mgpauly1458/ttihp26b-project/docs/dac_rows_layout.png

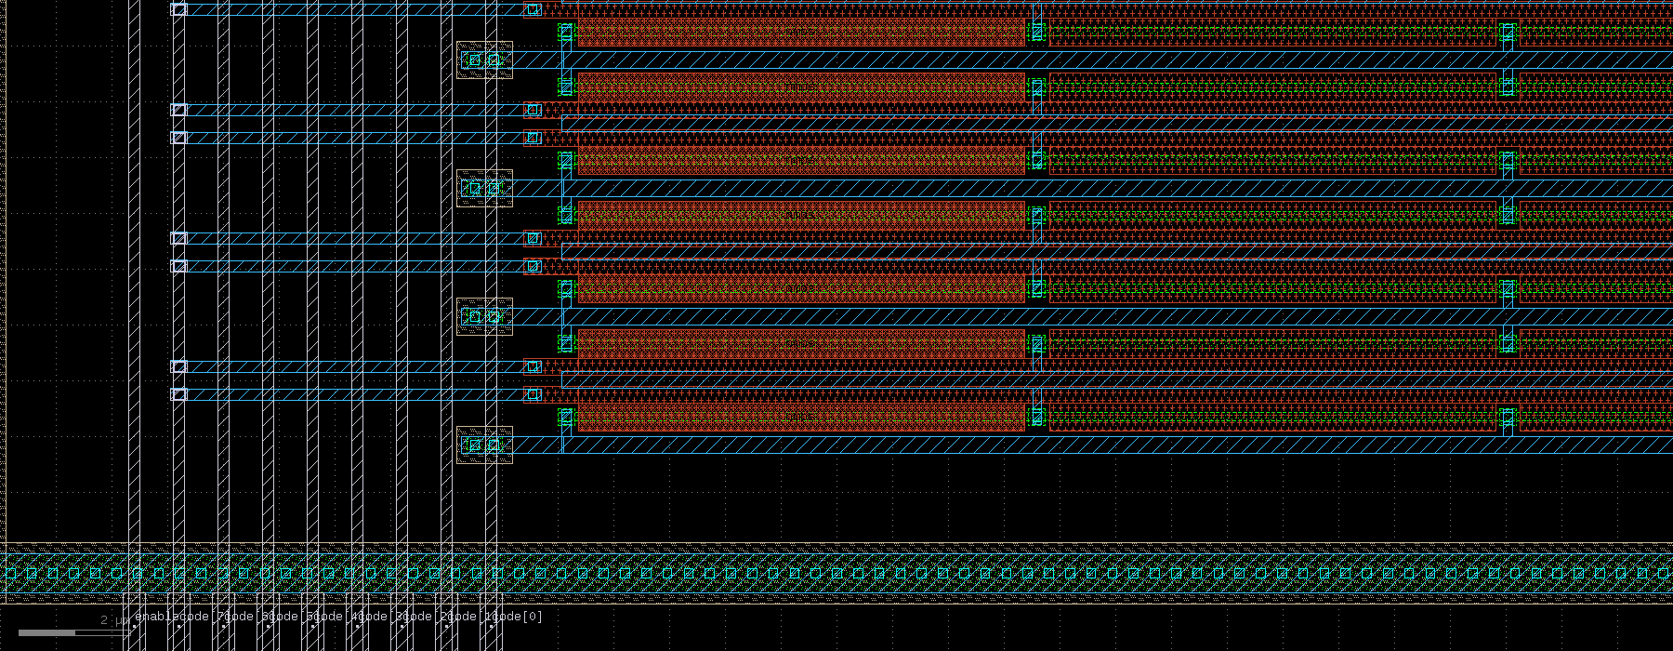
docs/dac_rows_layout.png
