mgpauly1458/ttihp26b-project/docs/ring_row_layout.png

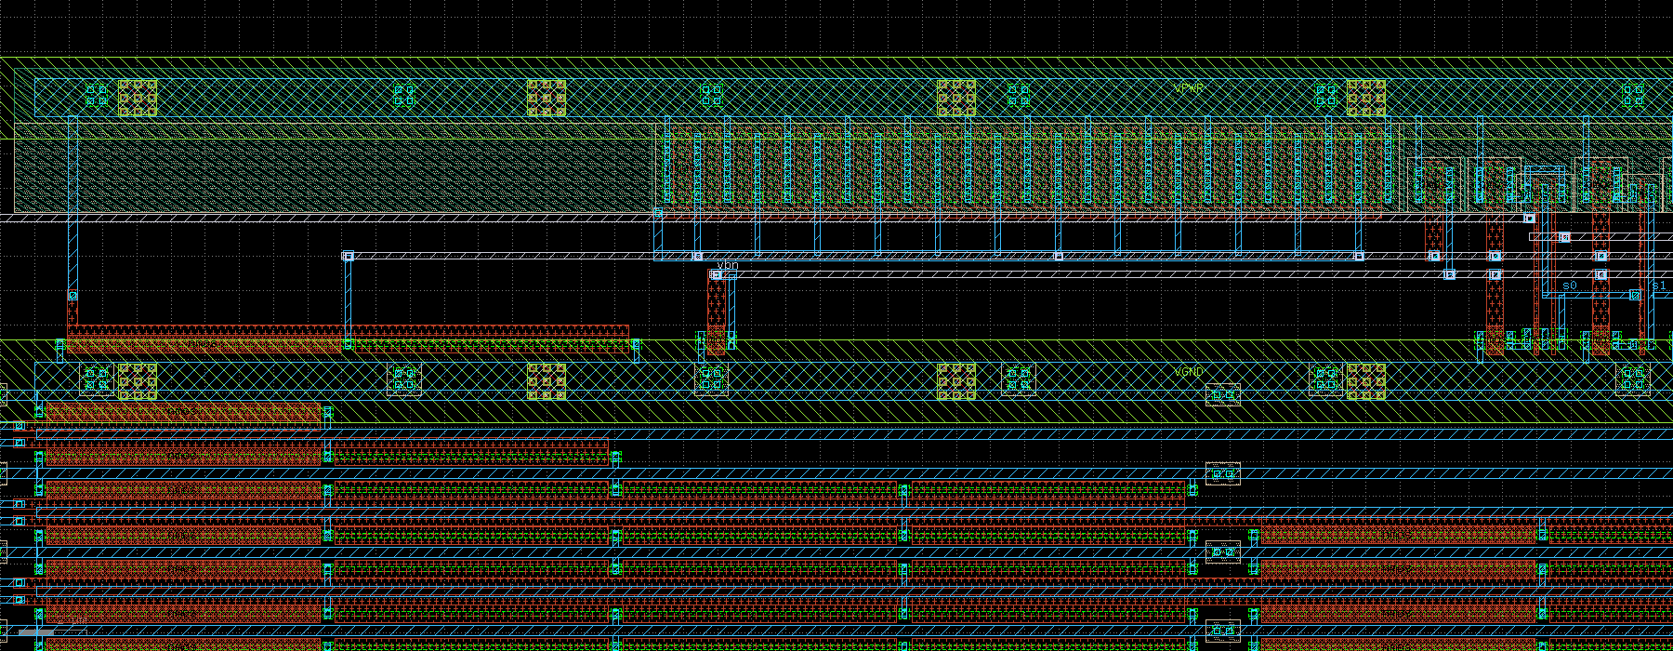
docs/ring_row_layout.png
