mgpauly1458/ttihp26b-project/docs/sch_csro_dac.png

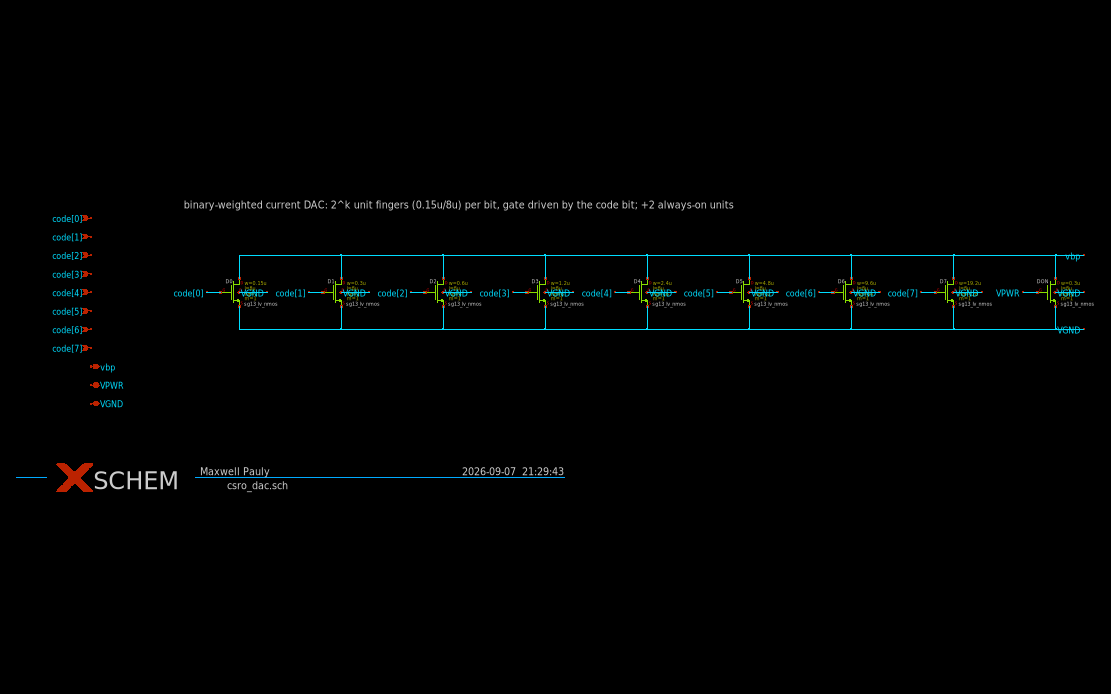
docs/sch_csro_dac.png
