mgpauly1458/ttihp26b-project/docs/sch_csro_inv.png

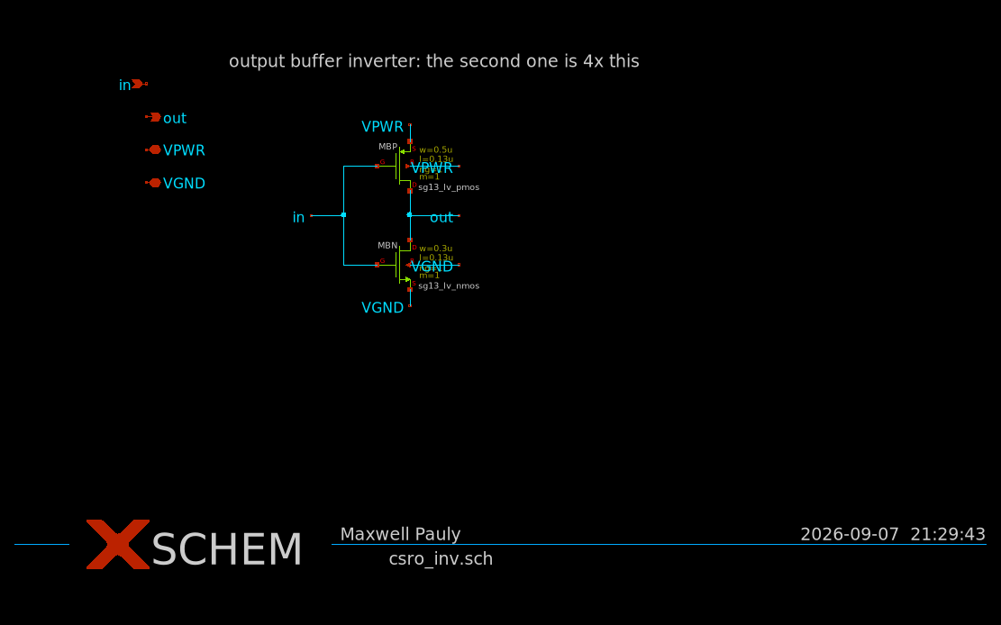
docs/sch_csro_inv.png
