mgpauly1458/ttihp26b-project/docs/sweep_error.png

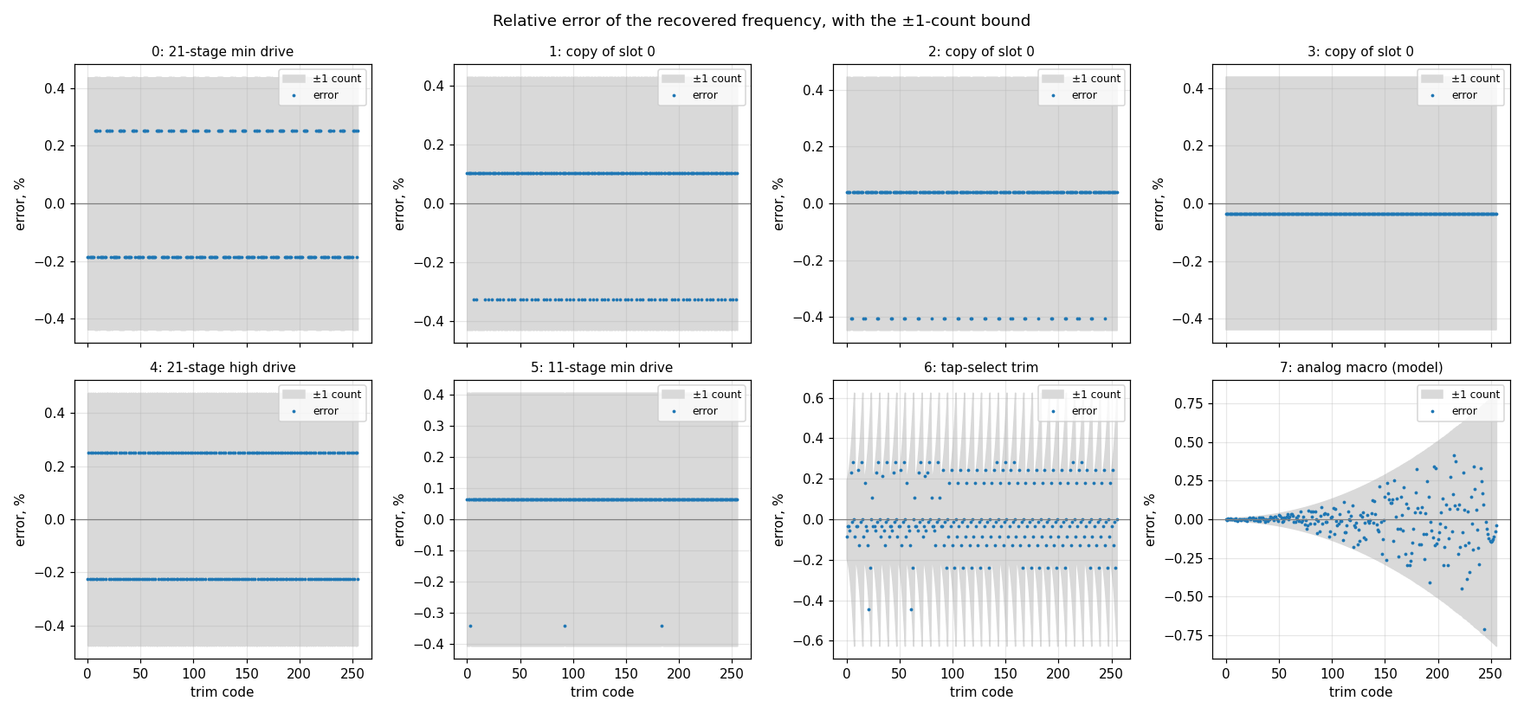
docs/sweep_error.png
