mgpauly1458/ttihp26b-project/docs/analog_verification_results.md

# Analog block verification: results

GENERATED by `make -C analog verify sim-post verify-ring-post verify-env verify-env-post` (analog/verify/*.py, ngspice in the iic-osic-tools container) on 2026-09-07. The strategy, and what the numbers mean, is in [analog_verification.md](analog_verification.md). Do not edit; rerun.

Corner names: process (tt, ss, ff, sf, fs) _ temperature _ supply. `SIGNOFF` corners are the three the tile's STA uses: tt 27 C 1.20 V, ss 125 C 1.08 V, ff -40 C 1.32 V.

---

## DAC: current against code
Drain held at 0.6 V. Endpoint fit; DNL/INL in units of the fitted LSB.
**Signoff corners** (the three LibreLane times the tile at):
| PVT | I(0) uA | I(1)-I(0) uA | unit uA | I(255) uA | DNL min | DNL max | at code | |INL| max | monotonic |
|---|---|---|---|---|---|---|---|---|---|
| tt_27C_1.20V | 5.16 | 2.58 | 2.575 | 662 | -0.000 | 0.000 | 128 | 0.00 | yes |
| ss_125C_1.08V | 2.66 | 1.31 | 1.307 | 336 | -0.000 | 0.000 | 128 | 0.00 | yes |
| ff_-40C_1.32V | 8.62 | 4.31 | 4.306 | 1107 | -0.000 | 0.000 | 128 | 0.00 | yes |

**All 45 PVT points**, extremes:
|  | min | at | max | at |
|---|---|---|---|---|
| unit current uA | 1.307 | ss_125C_1.08V | 4.306 | ff_-40C_1.32V |
| full scale uA | 336 | ss_125C_1.08V | 1107 | ff_-40C_1.32V |
| code-0 current uA | 2.66 | ss_125C_1.08V | 8.62 | ff_-40C_1.32V |
| DNL min | -0.001 | ff_125C_1.32V | -0.000 | ss_-40C_1.08V |
| DNL max | 0.000 | ss_-40C_1.08V | 0.000 | ff_125C_1.32V |
| |INL| max | 0.00 | ss_-40C_1.08V | 0.00 | ff_125C_1.32V |

Monotonic at 45 of 45 PVT points.

**Drain voltage sensitivity** (typical): the units are in triode, so the current follows the drain.
| PVT | I(0) uA | I(1)-I(0) uA | unit uA | I(255) uA | DNL min | DNL max | at code | |INL| max | monotonic |
|---|---|---|---|---|---|---|---|---|---|
| tt_27C_1.20V | 5.16 | 2.58 | 2.575 | 662 | -0.000 | 0.000 | 128 | 0.00 | yes |
| tt_27C_1.20V_vd0.46 | 4.43 | 2.21 | 2.212 | 569 | -0.000 | 0.000 | 128 | 0.00 | yes |
| tt_27C_1.20V_vd0.85 | 5.66 | 2.82 | 2.825 | 726 | -0.000 | 0.000 | 128 | 0.00 | yes |

## DAC: mismatch Monte Carlo, 200 samples (mos_tt_mismatch, 27 C, 1.2 V)
|  | value |
|---|---|
| samples monotonic | 200 / 200 |
| worst DNL (most negative step) | -0.393 LSB at code 128 |
| DNL min, mean over samples | -0.106 LSB |
| |INL| max, worst sample | 0.25 LSB |
| worst-DNL codes (count) | 128 (70), 64 (30), 192 (19) |
| unit current sigma/mean | 0.05 % |

## DAC: process Monte Carlo, 100 samples (mos_tt_stat, 27 C, 1.2 V)
|  | mean | sigma | sigma/mean | min | max |
|---|---|---|---|---|---|
| unit current uA | 2.560 | 0.113 | 4.4 % | 2.304 | 2.793 |
| code-0 current uA | 5.13 | 0.24 | 4.6 % | 4.61 | 5.67 |

Monotonic in 100 / 100 samples (global variation moves every finger together, so it cannot break the weighting).

---

## Bias chain: operating points against code
Stage starve devices measured with their drains at 0.6 V. The nominal mirror ratio is 48:1 (24 x 2 um diode, 1 um stage device).

**Signoff corners:**
| PVT | code | vbp V | vbn V | I_dac uA | I_stage(p) uA | I_stage(n) uA | I_dac/I_stage |
|---|---|---|---|---|---|---|---|
| tt_27C_1.20V | 0 | 0.855 | 0.255 | 5.7 | 0.13 | 0.18 | 44.0 |
| tt_27C_1.20V | 1 | 0.839 | 0.270 | 8.5 | 0.19 | 0.27 | 44.1 |
| tt_27C_1.20V | 16 | 0.746 | 0.352 | 49.9 | 1.12 | 1.33 | 44.7 |
| tt_27C_1.20V | 128 | 0.557 | 0.501 | 322.6 | 7.04 | 7.34 | 45.8 |
| tt_27C_1.20V | 255 | 0.461 | 0.572 | 569.3 | 12.32 | 12.45 | 46.2 |
| ss_125C_1.08V | 0 | 0.804 | 0.196 | 2.8 | 0.06 | 0.09 | 45.7 |
| ss_125C_1.08V | 1 | 0.785 | 0.213 | 4.2 | 0.09 | 0.14 | 45.7 |
| ss_125C_1.08V | 16 | 0.687 | 0.303 | 24.5 | 0.53 | 0.68 | 45.9 |
| ss_125C_1.08V | 128 | 0.514 | 0.453 | 158.6 | 3.41 | 3.66 | 46.6 |
| ss_125C_1.08V | 255 | 0.430 | 0.523 | 282.8 | 6.03 | 6.24 | 46.9 |
| ff_-40C_1.32V | 0 | 0.962 | 0.271 | 10.0 | 0.24 | 0.34 | 40.8 |
| ff_-40C_1.32V | 1 | 0.947 | 0.284 | 14.9 | 0.36 | 0.49 | 41.1 |
| ff_-40C_1.32V | 16 | 0.852 | 0.364 | 88.3 | 2.05 | 2.39 | 43.0 |
| ff_-40C_1.32V | 128 | 0.639 | 0.522 | 578.7 | 12.87 | 13.25 | 45.0 |
| ff_-40C_1.32V | 255 | 0.525 | 0.600 | 1021.1 | 22.46 | 22.46 | 45.5 |

**All 45 PVT points**, per-stage PMOS current extremes (this is what sets the ring's delay):
| code | min I_stage(p) uA | at | max I_stage(p) uA | at | max/min |
|---|---|---|---|---|---|
| 0 | 0.06 | ss_125C_1.08V | 0.24 | ff_-40C_1.32V | 4.0 |
| 1 | 0.09 | ss_125C_1.08V | 0.36 | ff_-40C_1.32V | 3.9 |
| 16 | 0.53 | ss_125C_1.08V | 2.05 | ff_-40C_1.32V | 3.8 |
| 128 | 3.41 | ss_125C_1.08V | 12.87 | ff_-40C_1.32V | 3.8 |
| 255 | 6.03 | ss_125C_1.08V | 22.46 | ff_-40C_1.32V | 3.7 |

I_dac / I_stage(p) over every PVT point and code >= 1: 41.1 .. 47.3 (nominal 48; the deviation is the diode and the stage device sitting at different drain voltages).

## Bias chain: mismatch Monte Carlo, 200 samples (mos_tt_mismatch, 27 C, 1.2 V)
| code | stage PMOS current sigma/mean %, mean | worst sample | worst max-min % | stage NMOS sigma/mean % | MPM/MPD ratio sigma % | I_dac sigma % |
|---|---|---|---|---|---|---|
| 1 | 7.4 | 12.4 | 42.5 | 18.9 | 8.1 | 1.32 |
| 16 | 4.5 | 7.8 | 26.8 | 12.4 | 4.9 | 0.26 |
| 255 | 1.7 | 3.1 | 10.8 | 5.3 | 1.9 | 0.11 |

Each row: across the eleven stages within one sample (mean and worst over samples), then the mirror ratio and the DAC current across samples.

## Bias chain: noise at the bias nodes (typical, 27 C, 1.2 V)
| code | vbn noise uVrms 1k-1G | 1-1G | 1k-1M | vbn LSB step mV | noise/LSB % (1k-1G) | noise/LSB % (1k-1M) | vbp noise uVrms 1k-1G | 1-1G | 1k-1M | vbp LSB step mV | noise/LSB % (1k-1G) | noise/LSB % (1k-1M) |
|---|---|---|---|---|---|---|---|---|---|---|---|---|
| 1 | 679.1 | 686.3 | 124.4 | 11.17 | 6.1 | 1.11 | 189.0 | 189.4 | 15.9 | 12.24 | 1.5 | 0.13 |
| 16 | 585.3 | 594.1 | 109.3 | 3.12 | 18.8 | 3.50 | 147.4 | 147.9 | 13.8 | 3.72 | 4.0 | 0.37 |
| 128 | 499.1 | 511.5 | 114.2 | 0.75 | 66.9 | 15.29 | 86.2 | 87.3 | 14.0 | 0.99 | 8.7 | 1.41 |
| 255 | 473.5 | 488.1 | 120.0 | 0.43 | 110.3 | 27.95 | 66.2 | 67.6 | 14.0 | 0.59 | 11.2 | 2.36 |

Integrated output noise (rms) of the bias nodes with the code held, from ngspice `.noise` (PSP thermal + flicker; ngspice reports onoise_total as the rms voltage). "LSB step" is how far the node moves for one code step at that code; noise/LSB is the rms noise as a percentage of that step. The 1 kHz-1 GHz figure is everything the node carries; most of it is white noise above 1 MHz, which the ring turns into period jitter that a reciprocal count averages (ring.py measures that directly). The 1 kHz-1 MHz figure is the slow part that behaves like a code error within one measurement, and is the one to compare with a code step.

---

## Stage: delay against code and corner
A starved inverter driven by and loading identical stages, with the real bias chain at the code shown. The last column is 1 / (11 x (tPLH + tPHL)): the period an 11-stage ring of these would have.

**Signoff corners:**
| PVT | code | tPLH ps | tPHL ps | mean ps | rise 20-80 ps | fall 20-80 ps | slope up V/ns | slope down V/ns | 11-stage ring MHz |
|---|---|---|---|---|---|---|---|---|---|
| tt_27C_1.20V | 0 | 9818 | 10878 | 10348 | 16233 | 11466 | 0.05 | 0.10 | 4.4 |
| tt_27C_1.20V | 16 | 1011 | 1208 | 1110 | 1801 | 1443 | 0.53 | 0.67 | 41.0 |
| tt_27C_1.20V | 128 | 170 | 210 | 190 | 262 | 238 | 3.46 | 3.39 | 238.8 |
| tt_27C_1.20V | 255 | 114 | 136 | 125 | 154 | 139 | 6.07 | 5.72 | 363.4 |
| ss_125C_1.08V | 0 | 17341 | 20090 | 18716 | 29550 | 21057 | 0.02 | 0.05 | 2.4 |
| ss_125C_1.08V | 16 | 1765 | 2253 | 2009 | 3198 | 2649 | 0.28 | 0.32 | 22.6 |
| ss_125C_1.08V | 128 | 309 | 390 | 350 | 457 | 431 | 1.81 | 1.71 | 130.0 |
| ss_125C_1.08V | 255 | 203 | 250 | 227 | 261 | 252 | 3.17 | 2.89 | 200.5 |
| ff_-40C_1.32V | 0 | 6586 | 6502 | 6544 | 10035 | 6666 | 0.08 | 0.18 | 6.9 |
| ff_-40C_1.32V | 16 | 673 | 751 | 712 | 1152 | 873 | 0.79 | 1.27 | 63.9 |
| ff_-40C_1.32V | 128 | 104 | 128 | 116 | 171 | 148 | 5.76 | 6.00 | 391.6 |
| ff_-40C_1.32V | 255 | 69 | 83 | 76 | 102 | 87 | 10.25 | 10.04 | 598.0 |

**All 45 PVT points**, delay extremes:
| code | fastest mean delay ps | at | slowest mean delay ps | at | slow/fast |
|---|---|---|---|---|---|
| 0 | 6544 | ff_-40C_1.32V | 19033 | sf_125C_1.08V | 2.91 |
| 16 | 712 | ff_-40C_1.32V | 2009 | ss_125C_1.08V | 2.82 |
| 128 | 116 | ff_-40C_1.32V | 350 | ss_125C_1.08V | 3.01 |
| 255 | 76 | ff_-40C_1.32V | 227 | ss_125C_1.08V | 2.98 |

## Stage: thermal noise to timing jitter (typical, 27 C, 1.2 V)
| code | trip point V | gain at trip | output noise mVrms (1k-100G) | slope V/ns | sigma_td per transition ps | sigma per period ps (x sqrt 22) | ppm of period | ppm over N=200 periods |
|---|---|---|---|---|---|---|---|---|
| 0 | 0.610 | -17.9 | 48.88 | 0.07 | 679.6 | 3187.7 | 14002 | 990 |
| 16 | 0.620 | -18.9 | 20.70 | 0.60 | 34.5 | 161.7 | 6625 | 468 |
| 128 | 0.605 | -18.1 | 5.88 | 3.43 | 1.7 | 8.0 | 1922 | 136 |
| 255 | 0.605 | -18.0 | 5.68 | 5.89 | 1.0 | 4.5 | 1641 | 116 |

Estimate: output noise of the stage held at its trip point (ngspice `.noise`, the load being the next stage), divided by the output slope at the half-rail crossing from the transient. Twenty-two such transitions make a period, uncorrelated, so the period jitter is sqrt(22) larger; a measurement of N periods averages it by sqrt(N). This is the white-noise floor of the instrument; it excludes the bias chain (bias.py) and the supply.

---

## NAND: enable=0 holds the loop
The output of the starved NAND with `enable` low, over a full-rail sweep of the feedback input, loaded by a stage. It never leaves the high rail; the stopped ring is stopped.

| PVT | code | VDD | min V(out) with enable=0 | as fraction of VDD | supply current uA (enable=0, whole NAND+bias, min over b) |
|---|---|---|---|---|---|
| tt_27C_1.20V | 0 | 1.20 | 1.2000 | 1.0000 | 5.8 |
| tt_27C_1.20V | 16 | 1.20 | 1.2000 | 1.0000 | 51.1 |
| tt_27C_1.20V | 255 | 1.20 | 1.2000 | 1.0000 | 581.7 |
| ss_125C_1.08V | 0 | 1.08 | 1.0799 | 0.9999 | 2.9 |
| ss_125C_1.08V | 16 | 1.08 | 1.0800 | 1.0000 | 25.0 |
| ss_125C_1.08V | 255 | 1.08 | 1.0800 | 1.0000 | 288.9 |
| ff_-40C_1.32V | 0 | 1.32 | 1.3200 | 1.0000 | 10.2 |
| ff_-40C_1.32V | 16 | 1.32 | 1.3200 | 1.0000 | 90.4 |
| ff_-40C_1.32V | 255 | 1.32 | 1.3200 | 1.0000 | 1043.6 |

Worst over all 135 runs (45 PVT x 3 codes): V(out) min = 1.0789 V = 99.90 % of VDD at ff_125C_1.08V code 0.

## NAND: as the eleventh inverter (enable=1)
| PVT | code | NAND tPLH ps | NAND tPHL ps | stage tPLH ps | stage tPHL ps | NAND/stage (mean) |
|---|---|---|---|---|---|---|
| tt_27C_1.20V | 0 | 13890 | 11059 | 9818 | 10878 | 1.21 |
| tt_27C_1.20V | 16 | 1450 | 1227 | 1011 | 1208 | 1.21 |
| tt_27C_1.20V | 255 | 160 | 146 | 114 | 136 | 1.22 |
| ss_125C_1.08V | 0 | 25594 | 20278 | 17341 | 20090 | 1.23 |
| ss_125C_1.08V | 16 | 2599 | 2288 | 1765 | 2253 | 1.22 |
| ss_125C_1.08V | 255 | 287 | 263 | 203 | 250 | 1.21 |
| ff_-40C_1.32V | 0 | 9126 | 6499 | 6586 | 6502 | 1.19 |
| ff_-40C_1.32V | 16 | 945 | 761 | 673 | 751 | 1.20 |
| ff_-40C_1.32V | 255 | 98 | 90 | 69 | 83 | 1.23 |

NAND delay / stage delay over all PVT points and codes: 1.14 .. 1.24. (Its NMOS are 0.6 um against the stage's 0.3 um to make up for the series stack.)

---

## Output buffer: swing and edges at 332 MHz
**Signoff corners**, both loads:
| PVT | load fF | VDD | V high | V low | high/VDD | low/VDD | rise 20-80 ps | fall 20-80 ps | delay ps |
|---|---|---|---|---|---|---|---|---|---|
| tt_27C_1.20V | 15 | 1.20 | 1.239 | -0.0308 | 1.032 | -0.0256 | 49 | 51 | 115 |
| tt_27C_1.20V | 108 | 1.20 | 1.210 | -0.0079 | 1.008 | -0.0066 | 258 | 245 | 262 |
| ss_125C_1.08V | 15 | 1.08 | 1.117 | -0.0307 | 1.034 | -0.0284 | 78 | 82 | 171 |
| ss_125C_1.08V | 108 | 1.08 | 1.088 | -0.0071 | 1.008 | -0.0065 | 401 | 403 | 404 |
| ff_-40C_1.32V | 15 | 1.32 | 1.354 | -0.0250 | 1.026 | -0.0189 | 33 | 34 | 83 |
| ff_-40C_1.32V | 108 | 1.32 | 1.330 | -0.0075 | 1.008 | -0.0057 | 165 | 168 | 177 |

**All 45 PVT points into 108 fF**: lowest high level 1.328 V (100.6 % of VDD) at ff_125C_1.32V; highest low level -0.0056 V at ff_125C_1.32V; slowest rise 401 ps at ss_125C_1.08V, slowest fall 403 ps at ss_125C_1.08V.

---

## Whole block: frequency and current against code
The macro's own netlist (the LVS reference), clk_out into 15 fF, released from enable=0 and measured over the last 16 of 40 nominal periods.

**Signoff corners:**
| PVT | code | f MHz | Idd running uA | Idd disabled uA | vbp V | vbn V | start-up ns | stage.py predicts MHz |
|---|---|---|---|---|---|---|---|---|
| tt_27C_1.20V | 0 | 3.81 | 6.6 | 5.8 | 0.855 | 0.255 | 127.3 | 4.4 |
| tt_27C_1.20V | 1 | 5.80 | 9.6 | 8.7 | 0.839 | 0.270 | 84.2 | n/a |
| tt_27C_1.20V | 2 | 7.82 | 12.7 | 11.5 | 0.827 | 0.281 | 63.0 | n/a |
| tt_27C_1.20V | 4 | 11.89 | 18.7 | 17.3 | 0.808 | 0.298 | 42.2 | n/a |
| tt_27C_1.20V | 8 | 20.11 | 30.7 | 28.6 | 0.782 | 0.321 | 25.4 | n/a |
| tt_27C_1.20V | 16 | 36.53 | 54.3 | 51.1 | 0.746 | 0.352 | 14.5 | 41.0 |
| tt_27C_1.20V | 32 | 68.35 | 100.3 | 94.9 | 0.698 | 0.391 | 8.0 | n/a |
| tt_27C_1.20V | 64 | 125.64 | 187.5 | 178.2 | 0.636 | 0.440 | 4.6 | n/a |
| tt_27C_1.20V | 128 | 215.66 | 344.9 | 329.7 | 0.557 | 0.501 | 2.8 | 238.8 |
| tt_27C_1.20V | 255 | 331.97 | 604.6 | 581.7 | 0.461 | 0.572 | 1.9 | 363.4 |
| ss_125C_1.08V | 0 | 2.11 | 3.3 | 2.9 | 0.804 | 0.196 | 229.9 | 2.4 |
| ss_125C_1.08V | 1 | 3.22 | 4.8 | 4.3 | 0.785 | 0.213 | 152.0 | n/a |
| ss_125C_1.08V | 2 | 4.34 | 6.2 | 5.7 | 0.771 | 0.226 | 113.5 | n/a |
| ss_125C_1.08V | 4 | 6.63 | 9.2 | 8.5 | 0.751 | 0.245 | 75.4 | n/a |
| ss_125C_1.08V | 8 | 11.25 | 15.0 | 14.1 | 0.723 | 0.270 | 45.4 | n/a |
| ss_125C_1.08V | 16 | 20.44 | 26.6 | 25.0 | 0.687 | 0.303 | 25.8 | 22.6 |
| ss_125C_1.08V | 32 | 38.00 | 49.1 | 46.5 | 0.641 | 0.343 | 14.4 | n/a |
| ss_125C_1.08V | 64 | 69.21 | 91.6 | 87.3 | 0.584 | 0.393 | 8.3 | n/a |
| ss_125C_1.08V | 128 | 118.46 | 169.4 | 162.1 | 0.514 | 0.453 | 5.0 | 130.0 |
| ss_125C_1.08V | 255 | 184.03 | 299.7 | 288.9 | 0.430 | 0.523 | 3.3 | 200.5 |
| ff_-40C_1.32V | 0 | 5.95 | 12.2 | 10.2 | 0.962 | 0.271 | 81.5 | 6.9 |
| ff_-40C_1.32V | 1 | 8.98 | 17.8 | 15.3 | 0.947 | 0.284 | 54.2 | n/a |
| ff_-40C_1.32V | 2 | 12.01 | 23.2 | 20.4 | 0.935 | 0.295 | 40.7 | n/a |
| ff_-40C_1.32V | 4 | 18.12 | 33.8 | 30.5 | 0.917 | 0.311 | 27.5 | n/a |
| ff_-40C_1.32V | 8 | 30.41 | 54.9 | 50.6 | 0.890 | 0.333 | 16.6 | n/a |
| ff_-40C_1.32V | 16 | 55.37 | 96.8 | 90.4 | 0.852 | 0.364 | 9.4 | 63.9 |
| ff_-40C_1.32V | 32 | 105.15 | 179.1 | 168.6 | 0.800 | 0.404 | 5.1 | n/a |
| ff_-40C_1.32V | 64 | 198.69 | 336.0 | 318.4 | 0.730 | 0.456 | 2.9 | n/a |
| ff_-40C_1.32V | 128 | 350.26 | 620.6 | 591.6 | 0.639 | 0.522 | 1.7 | 391.6 |
| ff_-40C_1.32V | 255 | 543.74 | 1087.4 | 1043.6 | 0.525 | 0.600 | 1.1 | 598.0 |

**All 45 PVT points**, frequency extremes per code, and monotonicity:
| code | slowest MHz | at | fastest MHz | at | fast/slow |
|---|---|---|---|---|---|
| 0 | 2.06 | sf_125C_1.08V | 5.96 | fs_-40C_1.32V | 2.89 |
| 1 | 3.12 | sf_125C_1.08V | 9.02 | fs_-40C_1.32V | 2.89 |
| 2 | 4.20 | sf_125C_1.08V | 12.08 | fs_-40C_1.32V | 2.88 |
| 4 | 6.39 | sf_125C_1.08V | 18.26 | fs_-40C_1.32V | 2.86 |
| 8 | 10.88 | sf_125C_1.08V | 30.46 | fs_-40C_1.32V | 2.80 |
| 16 | 20.10 | sf_125C_1.08V | 55.37 | ff_-40C_1.32V | 2.75 |
| 32 | 38.00 | ss_125C_1.08V | 105.15 | ff_-40C_1.32V | 2.77 |
| 64 | 69.21 | ss_125C_1.08V | 198.69 | ff_-40C_1.32V | 2.87 |
| 128 | 118.46 | ss_125C_1.08V | 350.26 | ff_-40C_1.32V | 2.96 |
| 255 | 184.03 | ss_125C_1.08V | 543.74 | ff_-40C_1.32V | 2.95 |

f(code) monotonic over the codes simulated at 45 of 45 PVT points.

**Stopped** (enable=0, every PVT point and code): clk_out never below 1.080 V at the operating point, 1.080 V during the hold. Disabled supply current is the DAC's (2.9 .. 1044 uA over codes and corners). **Start-up**: worst release-to-first-edge 230 ns at ss_125C_1.08V code 0.

**Supply pushing and temperature coefficient** (typical process):
| code | f @1.08 V | f @1.20 V | f @1.32 V | %/V | f @-40 C | f @125 C | ppm/C |
|---|---|---|---|---|---|---|---|
| 16 | 33.2 | 36.5 | 38.8 | 64.0 | 46.9 | 23.7 | -3859 |
| 128 | 178.3 | 215.7 | 248.2 | 135.1 | 255.7 | 163.6 | -2589 |
| 255 | 268.2 | 332.0 | 392.1 | 155.4 | 384.6 | 268.3 | -2124 |

## Whole block: mismatch Monte Carlo, 64 samples (mos_tt_mismatch, 27 C, 1.2 V)
| code | mean MHz | sigma MHz | sigma % | min | max |
|---|---|---|---|---|---|
| 0 | 3.79 | 0.383 | 10.09 | 3.16 | 5.02 |
| 15 | 34.26 | 2.334 | 6.81 | 30.00 | 39.74 |
| 16 | 36.32 | 2.488 | 6.85 | 31.46 | 43.01 |
| 127 | 214.04 | 8.123 | 3.80 | 197.78 | 232.61 |
| 128 | 215.22 | 8.232 | 3.82 | 199.40 | 234.85 |
| 255 | 331.53 | 9.330 | 2.81 | 310.73 | 352.68 |

Major-carry steps: f(16) - f(15) = 1.256 .. 3.269 MHz, f(128) - f(127) = 0.127 .. 2.240 MHz. Non-monotonic samples: 0 at 15->16, 0 at 127->128, of 64.

## Whole block: process Monte Carlo, 32 samples (mos_tt_stat, 27 C, 1.2 V)
| code | mean MHz | sigma MHz | sigma % | min | max |
|---|---|---|---|---|---|
| 0 | 3.84 | 0.219 | 5.70 | 3.18 | 4.19 |
| 16 | 36.39 | 1.945 | 5.35 | 30.56 | 39.40 |
| 255 | 327.69 | 18.406 | 5.62 | 281.85 | 363.99 |

f(255)/f(0), the span of the scale, 76.2 .. 92.9 across samples.

## Whole block: noise on the bias node and the jitter it makes
| code | vbp current noise pA/sqrt(Hz) (white, 10M-1G) | vbp impedance kohm (1 kHz) | vbp voltage noise nV/sqrt(Hz) at 1 kHz | white-part voltage noise nV/sqrt(Hz) |
|---|---|---|---|---|
| 16 | 4.47 | 1.3 | 151.6 | 6.0 |
| 128 | 8.51 | 0.4 | 163.7 | 3.4 |

**Transient with the bias-node current noise injected** (typical, 27 C, 1.2 V; 600 periods; `quiet` = same run without the source, the numerical floor):
| code | run | periods | mean period ns | period jitter ps rms | ppm | jitter of 50-period means ps | ppm |
|---|---|---|---|---|---|---|---|
| 16 | quiet | 612 | 27.3217 | 0.15 | 5 | 0.00 | 0 |
| 16 | noise | 612 | 27.3211 | 10.16 | 372 | 1.23 | 45 |
| 128 | quiet | 617 | 4.6294 | 0.03 | 7 | 0.01 | 1 |
| 128 | noise | 617 | 4.6292 | 0.84 | 181 | 0.12 | 27 |

The injected source carries the white part of the current noise every device on vbp contributes (DAC units, diode, always-on units), measured by `.noise` at the same operating point and divided by the node's impedance from an `ac` analysis. Flicker noise below 10 MHz is not injected: the bias node's own time constant already filters it into slow drift, which a reciprocal count averages, and the stage's own thermal jitter is in stage.py.

---

## Post-layout: where the parasitic capacitance is
kpex 2.5D on the flat macro: 334 capacitors, 721 fF in total (each counted once; the per-net column counts a coupling cap on both of its nets).

| block (group of nets) | nets | parasitic fF | to VPWR/VGND/substrate fF | to other signals fF |
|---|---|---|---|---|
| DAC and code buses | 8 | 478.1 | 321.0 | 157.1 |
| bias nodes | 2 | 255.3 | 140.5 | 114.8 |
| ring: stage outputs | 11 | 24.0 | 11.0 | 13.0 |
| ring: enable | 1 | 10.9 | 5.9 | 5.0 |
| ring: starved rails (unlabelled) | 23 | 5.3 | 3.1 | 2.2 |
| output buffer | 2 | 3.2 | 2.5 | 0.7 |

**Per net**, the ones that matter:
| net | parasitic fF | to supplies | to signals | largest partners (fF) | device cap on the net fF (Liberty, pre-layout) | wire / device % |
|---|---|---|---|---|---|---|
| code[0] | 8.52 | 3.15 | 5.37 | code[1] 3.8, VGND 3.1, code[7] 0.6 | 9.6 | 89 |
| code[1] | 12.24 | 3.76 | 8.48 | code[0] 3.8, VGND 3.7, code[2] 3.4 | 19.4 | 63 |
| code[2] | 16.96 | 6.06 | 10.90 | VGND 6.1, code[3] 5.5, code[1] 3.4 | 39.5 | 43 |
| code[3] | 25.33 | 11.85 | 13.48 | VGND 11.8, code[2] 5.5, code[4] 4.5 | 79.0 | 32 |
| code[4] | 35.41 | 20.28 | 15.13 | VGND 20.3, vbp 5.6, code[3] 4.5 | 159.0 | 22 |
| code[5] | 60.03 | 39.55 | 20.48 | VGND 39.5, vbp 11.2, code[4] 4.4 | 320.0 | 19 |
| code[6] | 109.60 | 78.29 | 31.31 | VGND 78.3, vbp 22.3, code[5] 4.2 | 643.0 | 17 |
| code[7] | 210.00 | 158.05 | 51.95 | VGND 158.0, vbp 44.6, code[6] 3.7 | 1295.0 | 16 |
| vbp | 238.31 | 133.70 | 104.61 | VGND 128.5, code[7] 44.6, code[6] 22.3 | n/a | n/a |
| vbn | 17.01 | 6.81 | 10.20 | vbp 7.7, VGND 6.7, s0 0.2 | n/a | n/a |
| enable | 10.91 | 5.91 | 5.00 | VGND 5.3, vbp 2.5, code[7] 1.6 | 2.2 | 496 |
| s0 | 1.79 | 0.87 | 0.92 | VGND 0.9, vbn 0.2, s1 0.1 | n/a | n/a |
| s1 | 1.66 | 0.88 | 0.78 | VGND 0.8, vbn 0.2, s2 0.1 | n/a | n/a |
| s2 | 1.66 | 0.88 | 0.78 | VGND 0.8, vbn 0.2, s1 0.1 | n/a | n/a |
| s3 | 1.66 | 0.88 | 0.78 | VGND 0.8, vbn 0.2, s2 0.1 | n/a | n/a |
| s4 | 1.66 | 0.88 | 0.78 | VGND 0.8, vbn 0.2, s3 0.1 | n/a | n/a |
| s5 | 1.66 | 0.88 | 0.78 | VGND 0.8, vbn 0.2, s4 0.1 | n/a | n/a |
| s6 | 1.67 | 0.88 | 0.78 | VGND 0.8, vbn 0.2, s5 0.1 | n/a | n/a |
| s7 | 1.67 | 0.89 | 0.78 | VGND 0.8, vbn 0.2, s6 0.1 | n/a | n/a |
| s8 | 1.66 | 0.88 | 0.79 | VGND 0.8, vbn 0.2, s7 0.1 | n/a | n/a |
| s9 | 1.69 | 0.87 | 0.82 | VGND 0.8, s10 0.2, vbn 0.2 | n/a | n/a |
| s10 | 7.26 | 2.23 | 5.03 | vbp 3.8, VGND 1.9, VPWR 0.3 | n/a | n/a |
| b1 | 1.64 | 1.14 | 0.50 | VGND 1.0, s10 0.3, clk_out 0.2 | n/a | n/a |
| clk_out | 1.56 | 1.34 | 0.23 | VGND 1.1, VPWR 0.2, b1 0.2 | n/a | n/a |

The stage outputs s1..s10 carry about 1.7 fF of wiring each: the output strap, its Metal1 jog across the row gap, and its coupling to the neighbouring straps and to the vbp/vbn/enable lines it runs under. A stage's own input is a 0.5 um and a 0.3 um gate at L = 0.13 um, about 1 fF, plus its drains; the wiring is therefore comparable to the device load, which is why the post-layout ring is slower (below). The code buses add 8 to 210 fF to gate loads of 10 to 1300 fF, i.e. 16 to 90 %, largest in fraction on the small bits whose few fingers still need a full-length bus.

## Post-layout: the same circuit twice (typical, 27 C, 1.2 V)
| code | f pre MHz | f post MHz | change % | stage delay pre ps | post ps | NAND pre ps | post ps | buffer s10->clk_out pre ps | post ps | vbp ripple pre mV | post mV | vbn ripple pre mV | post mV |
|---|---|---|---|---|---|---|---|---|---|---|---|---|---|
| 0 | 3.81 | 1.97 | -48 | 11497 | 22127 | 16180 | 33041 | 1539 | 2219 | 0.34 | 0.81 | 5.01 | 4.83 |
| 16 | 36.59 | 18.07 | -51 | 1188 | 2422 | 1789 | 3453 | 638 | 1013 | 0.56 | 1.17 | 5.28 | 5.37 |
| 128 | 215.94 | 105.38 | -51 | 205 | 424 | 273 | 513 | 291 | 481 | 0.54 | 1.67 | 7.03 | 7.79 |
| 255 | 332.34 | 164.25 | -51 | 133 | 270 | 180 | 341 | 230 | 381 | 0.34 | 1.60 | 6.73 | 7.75 |

**Code bus settling** (10-90 %, driven 0 -> 1.2 V through 500 ohm, ring disabled):
| code bit | pre-layout ps | post-layout ps |
|---|---|---|
| 0 | 45 | 47 |
| 7 | 1534 | 1774 |

Stage delay is the mean over the ten stages of the time from a crossing of s_k to the next crossing of s_k+1, read off the running ring over its last three periods; the NAND is s10 to s0, the buffer s10 to clk_out. The bias ripple is the peak-to-peak movement of vbp and vbn while the ring runs, which the layout's coupling of the stage straps to the bias lines increases. Code bus settling is what the tile's driver sees; the code is a DC control, so nanoseconds do not matter.

**Frequency against code, pre and post layout, signoff corners** (from `ring.py` and `ring.py --netlist <pex>`):
| PVT | code | f pre MHz | f post MHz | post/pre % |
|---|---|---|---|---|
| tt_27C_1.20V | 0 | 3.81 | 1.97 | 52 |
| tt_27C_1.20V | 1 | 5.80 | 2.97 | 51 |
| tt_27C_1.20V | 2 | 7.82 | 3.97 | 51 |
| tt_27C_1.20V | 4 | 11.89 | 5.99 | 50 |
| tt_27C_1.20V | 8 | 20.11 | 10.03 | 50 |
| tt_27C_1.20V | 16 | 36.53 | 18.04 | 49 |
| tt_27C_1.20V | 32 | 68.35 | 33.51 | 49 |
| tt_27C_1.20V | 64 | 125.64 | 61.27 | 49 |
| tt_27C_1.20V | 128 | 215.66 | 105.23 | 49 |
| tt_27C_1.20V | 255 | 331.97 | 164.04 | 49 |
| ss_125C_1.08V | 0 | 2.11 | 1.08 | 51 |
| ss_125C_1.08V | 1 | 3.22 | 1.62 | 50 |
| ss_125C_1.08V | 2 | 4.34 | 2.18 | 50 |
| ss_125C_1.08V | 4 | 6.63 | 3.29 | 50 |
| ss_125C_1.08V | 8 | 11.25 | 5.52 | 49 |
| ss_125C_1.08V | 16 | 20.44 | 9.91 | 49 |
| ss_125C_1.08V | 32 | 38.00 | 18.31 | 48 |
| ss_125C_1.08V | 64 | 69.21 | 33.21 | 48 |
| ss_125C_1.08V | 128 | 118.46 | 56.96 | 48 |
| ss_125C_1.08V | 255 | 184.03 | 89.70 | 49 |
| ff_-40C_1.32V | 0 | 5.95 | 3.17 | 53 |
| ff_-40C_1.32V | 1 | 8.98 | 4.74 | 53 |
| ff_-40C_1.32V | 2 | 12.01 | 6.34 | 53 |
| ff_-40C_1.32V | 4 | 18.12 | 9.52 | 53 |
| ff_-40C_1.32V | 8 | 30.41 | 15.76 | 52 |
| ff_-40C_1.32V | 16 | 55.37 | 28.34 | 51 |
| ff_-40C_1.32V | 32 | 105.15 | 53.21 | 51 |
| ff_-40C_1.32V | 64 | 198.69 | 99.56 | 50 |
| ff_-40C_1.32V | 128 | 350.26 | 174.52 | 50 |
| ff_-40C_1.32V | 255 | 543.74 | 273.45 | 50 |

---

## Whole block: frequency and current against code
The macro's own netlist (the LVS reference), clk_out into 15 fF, released from enable=0 and measured over the last 16 of 40 nominal periods.

**Signoff corners:**
| PVT | code | f MHz | Idd running uA | Idd disabled uA | vbp V | vbn V | start-up ns | stage.py predicts MHz |
|---|---|---|---|---|---|---|---|---|
| tt_27C_1.20V | 0 | 1.97 | 6.7 | 5.8 | 0.855 | 0.255 | 237.3 | 4.4 |
| tt_27C_1.20V | 1 | 2.97 | 9.7 | 8.7 | 0.839 | 0.270 | 157.4 | n/a |
| tt_27C_1.20V | 2 | 3.97 | 12.7 | 11.5 | 0.827 | 0.281 | 118.9 | n/a |
| tt_27C_1.20V | 4 | 5.99 | 18.6 | 17.3 | 0.808 | 0.298 | 79.7 | n/a |
| tt_27C_1.20V | 8 | 10.03 | 30.5 | 28.6 | 0.782 | 0.321 | 48.5 | n/a |
| tt_27C_1.20V | 16 | 18.04 | 53.8 | 51.1 | 0.746 | 0.352 | 27.8 | 41.0 |
| tt_27C_1.20V | 32 | 33.51 | 99.3 | 94.9 | 0.698 | 0.391 | 15.5 | n/a |
| tt_27C_1.20V | 64 | 61.27 | 185.4 | 178.2 | 0.636 | 0.440 | 8.8 | n/a |
| tt_27C_1.20V | 128 | 105.23 | 341.3 | 329.7 | 0.557 | 0.501 | 5.3 | 238.8 |
| tt_27C_1.20V | 255 | 164.04 | 599.3 | 581.7 | 0.461 | 0.572 | 3.5 | 363.4 |
| ss_125C_1.08V | 0 | 1.08 | 3.3 | 2.9 | 0.804 | 0.196 | 429.6 | 2.4 |
| ss_125C_1.08V | 1 | 1.62 | 4.8 | 4.3 | 0.785 | 0.213 | 287.0 | n/a |
| ss_125C_1.08V | 2 | 2.18 | 6.2 | 5.7 | 0.771 | 0.226 | 215.8 | n/a |
| ss_125C_1.08V | 4 | 3.29 | 9.1 | 8.5 | 0.751 | 0.245 | 144.6 | n/a |
| ss_125C_1.08V | 8 | 5.52 | 14.9 | 14.1 | 0.723 | 0.270 | 88.0 | n/a |
| ss_125C_1.08V | 16 | 9.91 | 26.3 | 25.0 | 0.687 | 0.303 | 50.4 | 22.6 |
| ss_125C_1.08V | 32 | 18.31 | 48.6 | 46.5 | 0.641 | 0.343 | 28.3 | n/a |
| ss_125C_1.08V | 64 | 33.21 | 90.7 | 87.3 | 0.584 | 0.393 | 16.2 | n/a |
| ss_125C_1.08V | 128 | 56.96 | 167.5 | 162.1 | 0.514 | 0.453 | 9.7 | 130.0 |
| ss_125C_1.08V | 255 | 89.70 | 297.4 | 288.9 | 0.430 | 0.523 | 6.3 | 200.5 |
| ff_-40C_1.32V | 0 | 3.17 | 12.4 | 10.2 | 0.962 | 0.271 | 146.1 | 6.9 |
| ff_-40C_1.32V | 1 | 4.74 | 17.6 | 15.3 | 0.947 | 0.284 | 96.9 | n/a |
| ff_-40C_1.32V | 2 | 6.34 | 23.1 | 20.4 | 0.935 | 0.295 | 74.1 | n/a |
| ff_-40C_1.32V | 4 | 9.52 | 33.7 | 30.5 | 0.917 | 0.311 | 49.6 | n/a |
| ff_-40C_1.32V | 8 | 15.76 | 54.7 | 50.6 | 0.890 | 0.333 | 30.4 | n/a |
| ff_-40C_1.32V | 16 | 28.34 | 96.2 | 90.4 | 0.852 | 0.364 | 17.4 | 63.9 |
| ff_-40C_1.32V | 32 | 53.21 | 177.5 | 168.6 | 0.800 | 0.404 | 9.6 | n/a |
| ff_-40C_1.32V | 64 | 99.56 | 332.7 | 318.4 | 0.730 | 0.456 | 5.4 | n/a |
| ff_-40C_1.32V | 128 | 174.52 | 614.5 | 591.6 | 0.639 | 0.522 | 3.2 | 391.6 |
| ff_-40C_1.32V | 255 | 273.45 | 1077.5 | 1043.6 | 0.525 | 0.600 | 2.1 | 598.0 |

**All 45 PVT points**, frequency extremes per code, and monotonicity:
| code | slowest MHz | at | fastest MHz | at | fast/slow |
|---|---|---|---|---|---|
| 0 | 1.08 | ss_125C_1.08V | 3.17 | ff_-40C_1.32V | 2.95 |
| 1 | 1.62 | ss_125C_1.08V | 4.74 | ff_-40C_1.32V | 2.92 |
| 2 | 2.18 | ss_125C_1.08V | 6.34 | ff_-40C_1.32V | 2.91 |
| 4 | 3.29 | ss_125C_1.08V | 9.52 | ff_-40C_1.32V | 2.89 |
| 8 | 5.52 | ss_125C_1.08V | 15.76 | ff_-40C_1.32V | 2.86 |
| 16 | 9.91 | ss_125C_1.08V | 28.34 | ff_-40C_1.32V | 2.86 |
| 32 | 18.31 | ss_125C_1.08V | 53.21 | ff_-40C_1.32V | 2.91 |
| 64 | 33.21 | ss_125C_1.08V | 99.56 | ff_-40C_1.32V | 3.00 |
| 128 | 56.96 | ss_125C_1.08V | 174.52 | ff_-40C_1.32V | 3.06 |
| 255 | 89.70 | ss_125C_1.08V | 273.45 | ff_-40C_1.32V | 3.05 |

f(code) monotonic over the codes simulated at 45 of 45 PVT points.

**Stopped** (enable=0, every PVT point and code): clk_out never below 1.080 V at the operating point, 1.080 V during the hold. Disabled supply current is the DAC's (2.9 .. 1044 uA over codes and corners). **Start-up**: worst release-to-first-edge 430 ns at ss_125C_1.08V code 0.

**Supply pushing and temperature coefficient** (typical process):
| code | f @1.08 V | f @1.20 V | f @1.32 V | %/V | f @-40 C | f @125 C | ppm/C |
|---|---|---|---|---|---|---|---|
| 16 | 16.2 | 18.0 | 19.4 | 75.2 | 22.9 | 12.3 | -3582 |
| 128 | 87.0 | 105.2 | 121.5 | 136.4 | 125.4 | 80.7 | -2569 |
| 255 | 133.0 | 164.0 | 193.5 | 153.6 | 191.9 | 132.5 | -2193 |

## Whole block: mismatch Monte Carlo, 64 samples (mos_tt_mismatch, 27 C, 1.2 V)
| code | mean MHz | sigma MHz | sigma % | min | max |
|---|---|---|---|---|---|
| 0 | 1.97 | 0.171 | 8.68 | 1.65 | 2.32 |
| 15 | 17.01 | 0.999 | 5.87 | 14.77 | 18.97 |
| 16 | 18.00 | 1.040 | 5.78 | 15.55 | 20.16 |
| 127 | 104.38 | 3.008 | 2.88 | 97.50 | 110.30 |
| 128 | 104.96 | 3.062 | 2.92 | 98.12 | 111.45 |
| 255 | 163.65 | 3.465 | 2.12 | 156.01 | 171.12 |

Major-carry steps: f(16) - f(15) = 0.627 .. 1.320 MHz, f(128) - f(127) = -0.120 .. 1.209 MHz. Non-monotonic samples: 0 at 15->16, 1 at 127->128, of 64.

## Whole block: process Monte Carlo, 32 samples (mos_tt_stat, 27 C, 1.2 V)
| code | mean MHz | sigma MHz | sigma % | min | max |
|---|---|---|---|---|---|
| 0 | 1.98 | 0.122 | 6.17 | 1.61 | 2.17 |
| 16 | 17.98 | 1.014 | 5.64 | 14.95 | 19.67 |
| 255 | 162.11 | 9.110 | 5.62 | 139.39 | 180.28 |

f(255)/f(0), the span of the scale, 74.5 .. 88.6 across samples.

## Whole block: noise on the bias node and the jitter it makes
| code | vbp current noise pA/sqrt(Hz) (white, 10M-1G) | vbp impedance kohm (1 kHz) | vbp voltage noise nV/sqrt(Hz) at 1 kHz | white-part voltage noise nV/sqrt(Hz) |
|---|---|---|---|---|
| 16 | 4.47 | 1.3 | 151.6 | 6.0 |
| 128 | 8.52 | 0.4 | 163.7 | 3.4 |

**Transient with the bias-node current noise injected** (typical, 27 C, 1.2 V; 600 periods; `quiet` = same run without the source, the numerical floor):
| code | run | periods | mean period ns | period jitter ps rms | ppm | jitter of 50-period means ps | ppm |
|---|---|---|---|---|---|---|---|
| 16 | quiet | 604 | 55.3332 | 0.74 | 13 | 0.01 | 0 |
| 16 | noise | 604 | 55.3308 | 14.13 | 255 | 2.58 | 47 |
| 128 | quiet | 602 | 9.4862 | 0.04 | 4 | 0.00 | 0 |
| 128 | noise | 602 | 9.4859 | 1.27 | 134 | 0.13 | 14 |

The injected source carries the white part of the current noise every device on vbp contributes (DAC units, diode, always-on units), measured by `.noise` at the same operating point and divided by the node's impedance from an `ac` analysis. Flicker noise below 10 MHz is not injected: the bias node's own time constant already filters it into slow drift, which a reciprocal count averages, and the stage's own thermal jitter is in stage.py.

---

## Environment: supply, ground and crosstalk (pre-layout netlist, typical, 27 C, 1.2 V)
| case | code | f MHz | shift ppm vs quiet | period jitter ps rms | 25-period mean jitter ps | max-min period ps | clk_out min V | edges | note |
|---|---|---|---|---|---|---|---|---|---|
| bounce_mvpp30_code16 | 16 | 36.594 | -152 | 32.28 | 1.12 | 105.2 | -0.017 | 179 |  |
| noise_mvrms10_code16 | 16 | 36.610 | 262 | 16.67 | 3.40 | 87.7 | -0.002 | 178 |  |
| quiet_code16 | 16 | 36.600 | 0 | 0.37 | 0.01 | 1.2 | -0.002 | 178 |  |
| ripple_mvpp100_code16 | 16 | 36.535 | -1782 | 119.40 | 3.80 | 383.5 | -0.002 | 179 |  |
| ripple_mvpp10_code16 | 16 | 36.599 | -15 | 11.89 | 0.46 | 39.1 | -0.002 | 178 |  |
| ripple_mvpp30_code16 | 16 | 36.595 | -151 | 35.71 | 1.17 | 116.6 | -0.002 | 178 |  |
| slow_enable_code16 | 16 | 36.600 | 0 | n/a | n/a | n/a | -0.002 | 57 | first edge 30.8 ns after enable starts rising; shortest early period 27.322 ns |
| step_code16 | 16 | 36.600 | 0 | n/a | n/a | n/a | -0.002 | 175 | before 36.600 MHz, after -50 mV 35.345 MHz (-34297 ppm); settled within 5.6 ns |
| xcode_bit0_code16 | 16 | 36.600 | 4 | 0.32 | 0.01 | 1.5 | -0.002 | 178 | gate moves -0.060..0.060 V |
| xcode_bit7_code16 | 16 | 36.600 | 4 | 2.18 | 0.08 | 8.8 | -0.002 | 179 | gate moves -0.045..0.045 V |
| xenable_running_code16 | 16 | 36.600 | 7 | 6.69 | 0.59 | 39.6 | -0.002 | 178 | enable dips to 1.140 V |
| xout_ff10_code16 | 16 | 36.597 | -97 | 12.68 | n/a | 107.2 | -0.101 | 40 | 39 periods; shortest 27.271 ns; 0 extra edge(s) at the 0.6 V threshold, clean |
| xout_ff20_code16 | 16 | 36.593 | -186 | 38.18 | n/a | 290.5 | -0.111 | 40 | 39 periods; shortest 27.181 ns; 0 extra edge(s) at the 0.6 V threshold, clean |
| xout_ff30_code16 | 16 | 36.590 | -274 | 44.22 | n/a | 277.3 | -0.173 | 40 | 39 periods; shortest 27.192 ns; 0 extra edge(s) at the 0.6 V threshold, clean |
| xout_ff5_code16 | 16 | 36.598 | -47 | 8.41 | n/a | 55.6 | -0.027 | 40 | 39 periods; shortest 27.295 ns; 0 extra edge(s) at the 0.6 V threshold, clean |
| bounce_mvpp30_code255 | 255 | 331.925 | -138 | 60.61 | 3.41 | 141.9 | -0.026 | 180 |  |
| noise_mvrms10_code255 | 255 | 332.103 | 398 | 9.17 | 2.34 | 46.8 | -0.012 | 180 |  |
| quiet_code255 | 255 | 331.971 | 0 | 0.02 | 0.01 | 0.1 | -0.011 | 180 |  |
| ripple_mvpp100_code255 | 255 | 331.416 | -1671 | 201.17 | 12.64 | 474.9 | -0.013 | 180 |  |
| ripple_mvpp10_code255 | 255 | 331.966 | -15 | 20.03 | 1.05 | 47.4 | -0.011 | 180 |  |
| ripple_mvpp30_code255 | 255 | 331.925 | -138 | 60.32 | 3.19 | 141.8 | -0.012 | 179 |  |
| slow_enable_code255 | 255 | 331.970 | -3 | n/a | n/a | n/a | -0.011 | 57 | first edge 6.0 ns after enable starts rising; shortest early period 3.012 ns |
| step_code255 | 255 | 331.970 | -1 | n/a | n/a | n/a | -0.012 | 172 | before 331.970 MHz, after -50 mV 305.706 MHz (-79118 ppm); settled within 3.9 ns |
| xcode_bit0_code255 | 255 | 331.972 | 4 | 0.08 | 0.02 | 0.6 | -0.011 | 180 | gate moves 1.140..1.260 V |
| xcode_bit7_code255 | 255 | 331.971 | 1 | 2.83 | 0.16 | 12.2 | -0.012 | 180 | gate moves 1.187..1.213 V |
| xenable_running_code255 | 255 | 331.980 | 28 | 1.12 | 0.10 | 12.5 | -0.011 | 180 | enable dips to 1.139 V |
| xenable_stopped_code255 | 255 | n/a | n/a | n/a | n/a | n/a | 1.200 | 0 | enable peak 0.060 V |
| xout_ff10_code255 | 255 | 331.941 | -91 | 4.86 | n/a | 36.8 | -0.092 | 40 | 39 periods; shortest 2.994 ns; 0 extra edge(s) at the 0.6 V threshold, clean |
| xout_ff20_code255 | 255 | 331.926 | -136 | 13.65 | n/a | 87.8 | -0.144 | 40 | 39 periods; shortest 2.968 ns; 0 extra edge(s) at the 0.6 V threshold, clean |
| xout_ff30_code255 | 255 | 331.922 | -147 | 25.38 | n/a | 169.3 | -0.151 | 40 | 39 periods; shortest 2.928 ns; 0 extra edge(s) at the 0.6 V threshold, clean |
| xout_ff5_code255 | 255 | 331.952 | -56 | 2.74 | n/a | 21.1 | -0.051 | 40 | 39 periods; shortest 3.002 ns; 0 extra edge(s) at the 0.6 V threshold, clean |

Shift is the mean frequency over the run against the quiet run at the same code; the counter reads that mean. Period jitter is what the ring does cycle to cycle; the 25-period mean jitter is closer to what a reciprocal count over hundreds of periods scatters by. 50 MHz ripple and bounce are square waves with 1 ns edges; the crosstalk aggressor is a full-swing 50 MHz square with 200 ps edges through 20 fF (30 fF onto clk_out), the victim driven through 500 ohm. Every case of a code uses the same maximum time step.

---

## Environment: supply, ground and crosstalk (post-layout netlist, typical, 27 C, 1.2 V)
| case | code | f MHz | shift ppm vs quiet | period jitter ps rms | 25-period mean jitter ps | max-min period ps | clk_out min V | edges | note |
|---|---|---|---|---|---|---|---|---|---|
| bounce_mvpp30_code16 | 16 | 18.067 | -354 | 126.65 | 4.58 | 362.1 | -0.016 | 88 |  |
| noise_mvrms10_code16 | 16 | 18.082 | 492 | 27.81 | 5.36 | 133.8 | -0.002 | 88 |  |
| quiet_code16 | 16 | 18.074 | 0 | 0.22 | 0.00 | 0.7 | -0.001 | 88 |  |
| ripple_mvpp100_code16 | 16 | 18.001 | -3985 | 460.49 | 42.61 | 1495.8 | -0.001 | 88 |  |
| ripple_mvpp10_code16 | 16 | 18.073 | -13 | 44.50 | 1.33 | 125.5 | -0.001 | 88 |  |
| ripple_mvpp30_code16 | 16 | 18.067 | -346 | 132.63 | 5.12 | 381.2 | -0.001 | 89 |  |
| slow_enable_code16 | 16 | 18.074 | 0 | n/a | n/a | n/a | -0.001 | 28 | first edge 58.3 ns after enable starts rising; shortest early period 55.329 ns |
| step_code16 | 16 | 18.074 | 0 | n/a | n/a | n/a | -0.001 | 86 | before 18.074 MHz, after -50 mV 17.361 MHz (-39418 ppm); settled within 33.6 ns |
| xcode_bit0_code16 | 16 | 18.074 | 1 | 0.24 | 0.02 | 1.0 | -0.001 | 88 | gate moves -0.061..0.061 V |
| xcode_bit7_code16 | 16 | 18.074 | 0 | 10.10 | 0.83 | 39.9 | -0.001 | 88 | gate moves -0.033..0.033 V |
| xenable_running_code16 | 16 | 18.074 | 8 | 5.66 | 0.52 | 26.2 | -0.001 | 89 | enable dips to 1.139 V |
| xout_ff10_code16 | 16 | 18.073 | -25 | 11.16 | n/a | 66.7 | -0.080 | 20 | 19 periods; shortest 55.298 ns; 0 extra edge(s) at the 0.6 V threshold, clean |
| xout_ff20_code16 | 16 | 18.073 | -51 | 30.37 | n/a | 182.1 | -0.109 | 20 | 19 periods; shortest 55.241 ns; 0 extra edge(s) at the 0.6 V threshold, clean |
| xout_ff30_code16 | 16 | 19.027 | 52739 | 12316.76 | n/a | 55165.0 | -0.288 | 21 | 20 periods; shortest 0.230 ns; 1 extra edge(s) at the 0.6 V threshold - GLITCH |
| xout_ff5_code16 | 16 | 18.072 | -58 | 21.98 | n/a | 114.3 | -0.045 | 20 | 19 periods; shortest 55.273 ns; 0 extra edge(s) at the 0.6 V threshold, clean |
| bounce_mvpp30_code255 | 255 | 164.215 | -241 | 102.36 | 4.92 | 280.6 | -0.021 | 89 |  |
| noise_mvrms10_code255 | 255 | 164.264 | 52 | 14.20 | 4.65 | 80.3 | -0.007 | 89 |  |
| quiet_code255 | 255 | 164.255 | 0 | 0.07 | 0.00 | 0.2 | -0.006 | 89 |  |
| ripple_mvpp100_code255 | 255 | 163.997 | -1568 | 340.15 | 15.87 | 941.8 | -0.008 | 89 |  |
| ripple_mvpp10_code255 | 255 | 164.250 | -29 | 34.10 | 1.54 | 93.7 | -0.007 | 89 |  |
| ripple_mvpp30_code255 | 255 | 164.222 | -198 | 102.15 | 4.68 | 281.0 | -0.007 | 89 |  |
| slow_enable_code255 | 255 | 164.255 | -0 | n/a | n/a | n/a | -0.006 | 28 | first edge 9.2 ns after enable starts rising; shortest early period 6.088 ns |
| step_code255 | 255 | 164.255 | 0 | n/a | n/a | n/a | -0.007 | 85 | before 164.255 MHz, after -50 mV 151.407 MHz (-78217 ppm); settled within 5.5 ns |
| xcode_bit0_code255 | 255 | 164.255 | 2 | 0.09 | 0.01 | 0.5 | -0.007 | 89 | gate moves 1.140..1.260 V |
| xcode_bit7_code255 | 255 | 164.252 | -15 | 3.81 | 0.29 | 14.5 | -0.007 | 89 | gate moves 1.188..1.212 V |
| xenable_running_code255 | 255 | 164.243 | -74 | 1.35 | 0.08 | 6.2 | -0.007 | 89 | enable dips to 1.140 V |
| xenable_stopped_code255 | 255 | n/a | n/a | n/a | n/a | n/a | 1.200 | 0 | enable peak 0.060 V |
| xout_ff10_code255 | 255 | 164.241 | -83 | 1.44 | n/a | 8.6 | -0.041 | 20 | 19 periods; shortest 6.084 ns; 0 extra edge(s) at the 0.6 V threshold, clean |
| xout_ff20_code255 | 255 | 164.230 | -152 | 14.12 | n/a | 84.4 | -0.081 | 20 | 19 periods; shortest 6.047 ns; 0 extra edge(s) at the 0.6 V threshold, clean |
| xout_ff30_code255 | 255 | 164.220 | -212 | 27.95 | n/a | 167.3 | -0.120 | 20 | 19 periods; shortest 6.006 ns; 0 extra edge(s) at the 0.6 V threshold, clean |
| xout_ff5_code255 | 255 | 164.248 | -42 | 3.34 | n/a | 20.0 | -0.021 | 20 | 19 periods; shortest 6.078 ns; 0 extra edge(s) at the 0.6 V threshold, clean |

Shift is the mean frequency over the run against the quiet run at the same code; the counter reads that mean. Period jitter is what the ring does cycle to cycle; the 25-period mean jitter is closer to what a reciprocal count over hundreds of periods scatters by. 50 MHz ripple and bounce are square waves with 1 ns edges; the crosstalk aggressor is a full-swing 50 MHz square with 200 ps edges through 20 fF (30 fF onto clk_out), the victim driven through 500 ohm. Every case of a code uses the same maximum time step.
