mgpauly1458/ttihp26b-project/analog/out/verify/bias_corners.csv

PVT | code | vbp V | vbn V | I_dac uA | I_stage(p) uA | I_stage(n) uA | I_dac/I_stage
tt_-40C_1.08V | 0 | 0.691372125 | 0.307648328 | 5.68618697 | 0.126810645 | 0.174196026 | 44.83998145423833
tt_-40C_1.08V | 1 | 0.678229164 | 0.319861555 | 8.51450684 | 0.18932975000000002 | 0.25437093699999996 | 44.971837970524966
tt_-40C_1.08V | 16 | 0.600067797 | 0.387702336 | 50.2116436 | 1.09703214 | 1.29725227 | 45.77043987061309
tt_-40C_1.08V | 128 | 0.435804831 | 0.51416859 | 321.191075 | 6.889112330000001 | 7.1836416100000005 | 46.622998670134905
tt_-40C_1.08V | 255 | 0.353070125 | 0.573164704 | 559.177603 | 11.9185356 | 12.0613439 | 46.91663655390684
tt_-40C_1.20V | 0 | 0.804220627 | 0.314666269 | 7.119868530000001 | 0.161136775 | 0.21750560899999996 | 44.185249022142834
tt_-40C_1.20V | 1 | 0.790419863 | 0.327411818 | 10.6650756 | 0.24095986099999997 | 0.317370342 | 44.26079744460012
tt_-40C_1.20V | 16 | 0.706010241 | 0.399913017 | 63.145928100000006 | 1.40266567 | 1.61968773 | 45.01851685013436
tt_-40C_1.20V | 128 | 0.521491957 | 0.540372113 | 411.767037 | 8.94704733 | 9.17637093 | 46.022673381789296
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
