mgpauly1458/ttihp26b-project/analog/out/verify/buffer_corners.csv

PVT | load fF | VDD | V high | V low | high/VDD | low/VDD | rise 20-80 ps | fall 20-80 ps | delay ps
tt_-40C_1.08V | 15.0 | 1.08 | 1.12578 | -0.0379262 | 1.0423888888888888 | -0.03511685185185185 | 57.734 | 62.26 | 139.57399999999998
tt_-40C_1.08V | 108.0 | 1.08 | 1.09044 | -0.0083913 | 1.0096666666666667 | -0.007769722222222222 | 297.00600000000003 | 301.39 | 312.297
tt_-40C_1.20V | 15.0 | 1.2 | 1.24383 | -0.0349371 | 1.0365250000000001 | -0.02911425 | 46.372 | 48.84 | 113.425
tt_-40C_1.20V | 108.0 | 1.2 | 1.21083 | -0.00853829 | 1.009025 | -0.007115241666666668 | 241.561 | 236.06 | 252.569
tt_-40C_1.32V | 15.0 | 1.32 | 1.36156 | -0.0308924 | 1.0314848484848484 | -0.02340333333333333 | 39.278999999999996 | 40.699999999999996 | 96.822
tt_-40C_1.32V | 108.0 | 1.32 | 1.33102 | -0.00845388 | 1.008348484848485 | -0.006404454545454546 | 206.155 | 196.98 | 214.499
tt_27C_1.08V | 15.0 | 1.08 | 1.11973 | -0.0331912 | 1.036787037037037 | -0.03073259259259259 | 60.029 | 62.800000000000004 | 138.52700000000002
tt_27C_1.08V | 108.0 | 1.08 | 1.08951 | -0.007717 | 1.0088055555555555 | -0.00714537037037037 | 310.872 | 303.26 | 318.552
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
