mgpauly1458/ttihp26b-project/analog/out/verify/dac_corners.csv

PVT | I(0) uA | I(1)-I(0) uA | unit uA | I(255) uA | DNL min | DNL max | at code | |INL| max | monotonic
tt_-40C_1.08V | 5.57907064 | 2.7894568300000007 | 2.789449138666667 | 716.888601 | -1.7257409705928595e-05 | 2.818238642232629e-06 | 128 | 1.1566441384326565e-05 | yes
tt_-40C_1.20V | 6.72942313 | 3.3646359699999997 | 3.364622666156863 | 864.708203 | -2.45692206973791e-05 | 3.9629534931417965e-06 | 128 | 1.6450325271552938e-05 | yes
tt_-40C_1.32V | 7.73280107 | 3.8663298300000006 | 3.8663070663921575 | 993.641103 | -3.64860808260703e-05 | 5.931657156788006e-06 | 128 | 2.453810354422598e-05 | yes
tt_27C_1.08V | 4.34909444 | 2.17093146 | 2.1709188531764703 | 557.933402 | -3.632248915697023e-05 | 6.055879792965513e-06 | 128 | 2.4326050838856105e-05 | yes
tt_27C_1.20V | 5.15755647 | 2.5751674899999992 | 2.5751451707058823 | 661.819575 | -5.4043829233574314e-05 | 8.865245524791732e-06 | 128 | 3.6051605440369725e-05 | yes
tt_27C_1.32V | 5.86982778 | 2.931311640000001 | 2.931272875372549 | 753.3444109999999 | -8.217432589630036e-05 | 1.3347316722533975e-05 | 128 | 5.521950968108253e-05 | yes
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
