mgpauly1458/ttihp26b-project/analog/out/verify/bias_mm.csv

code | sample | isp_sigma_pct | isn_sigma_pct | mirror_ratio_x48 | idac_A
1 | 0 | 7.460240542801282 | 17.39123332722956 | 1.165985653236657 | 8.55094052e-06
1 | 1 | 5.834294492649165 | 18.24531589612469 | 1.1945019989913879 | 8.36849028e-06
1 | 2 | 6.138141867950361 | 14.019351659398735 | 1.1197109712199003 | 8.48537782e-06
1 | 3 | 7.200140148816462 | 20.89592183827699 | 1.1207335941206646 | 8.51704972e-06
1 | 4 | 6.299534356429144 | 17.3209899962781 | 1.1963794759012487 | 8.43150416e-06
1 | 5 | 7.563664802158521 | 19.873849873621673 | 1.2467906582641604 | 8.47006481e-06
1 | 6 | 9.396414481141097 | 26.217096970957062 | 1.256884252572963 | 8.34553808e-06
1 | 7 | 7.644464763174749 | 17.085026901416363 | 1.0401136491039702 | 8.44784839e-06
1 | 8 | 10.575085727481506 | 23.7532203639552 | 1.1571321071484006 | 8.47296118e-06
1 | 9 | 5.241154092182359 | 15.551175201316607 | 1.2426507995758298 | 8.68590225e-06
1 | 10 | 8.076146244022631 | 23.95491866302201 | 1.2234118278286776 | 8.58235681e-06
1 | 11 | 9.027496315942313 | 17.67323309308946 | 1.0325864840962697 | 8.61082132e-06
1 | 12 | 8.042349290078608 | 27.920997677016132 | 1.0981644727631614 | 8.50839077e-06
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
