mgpauly1458/ttihp26b-project/analog/out/verify/dac_mm.csv

sample | unit_A | ifs_A | dnl_min | dnl_max | worst_code | inl_max | monotonic
0 | 2.5755449907843136e-06 | 0.000661900639 | -0.0402353642258646 | 0.07483546585493217 | 32 | 0.0775439459544337 | True
1 | 2.5745661810980393e-06 | 0.000661744124 | -0.13160903906286958 | 0.05717849476265413 | 192 | 0.11531673709951082 | True
2 | 2.5762315870588234e-06 | 0.000662170953 | -0.07722115824453168 | 0.03575897966779329 | 48 | 0.07521189697354609 | True
3 | 2.5754154567058826e-06 | 0.00066192853 | -0.0258200891560032 | 0.07852773530869661 | 80 | 0.054554070165078426 | True
4 | 2.574723125254902e-06 | 0.000661702926 | -0.29728715982970955 | 0.05159812076179726 | 128 | 0.18458774868439465 | True
5 | 2.5732502177254902e-06 | 0.000661409079 | -0.07418952747403418 | 0.14213844411829535 | 192 | 0.15390882642112477 | True
6 | 2.575727700117647e-06 | 0.000661880789 | -0.23840707233518565 | 0.12776090417761532 | 128 | 0.21516533886190048 | True
7 | 2.57610378172549e-06 | 0.000662035704 | -0.0670981436973368 | 0.12390192527911537 | 200 | 0.12533123126246376 | True
8 | 2.5753881136862745e-06 | 0.000661849836 | -0.015514598935213564 | 0.20723008057603187 | 192 | 0.1609451993088565 | True
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
