mgpauly1458/ttihp26b-project/docs/verify_bias.png

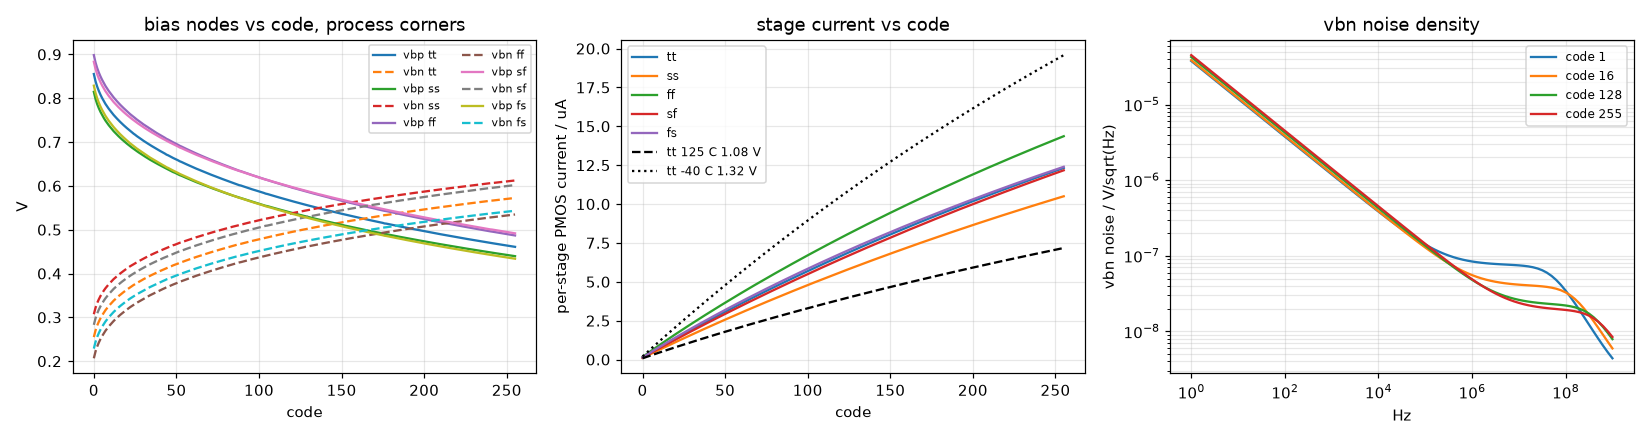
docs/verify_bias.png
