mgpauly1458/ttihp26b-project/docs/verify_dac.png

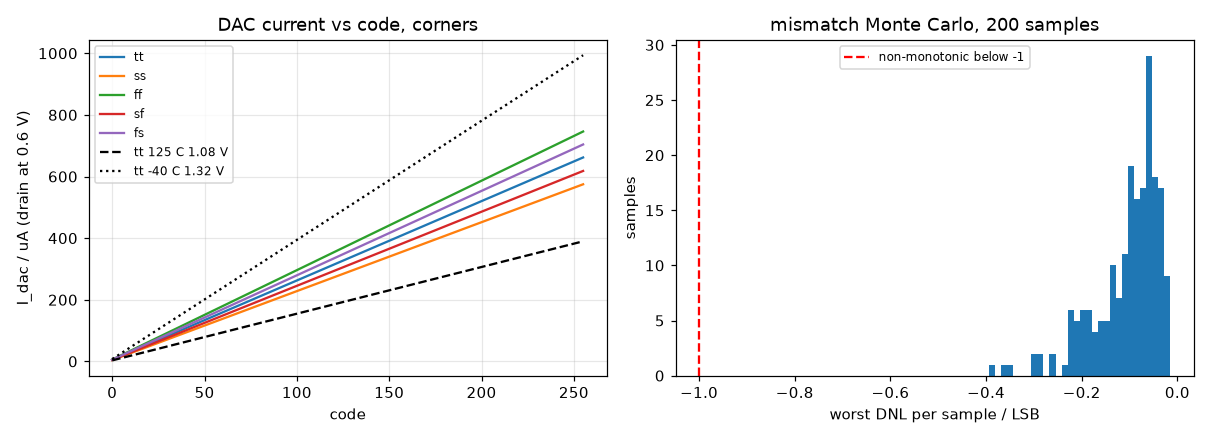
docs/verify_dac.png
