mgpauly1458/ttihp26b-project/docs/verify_env.png

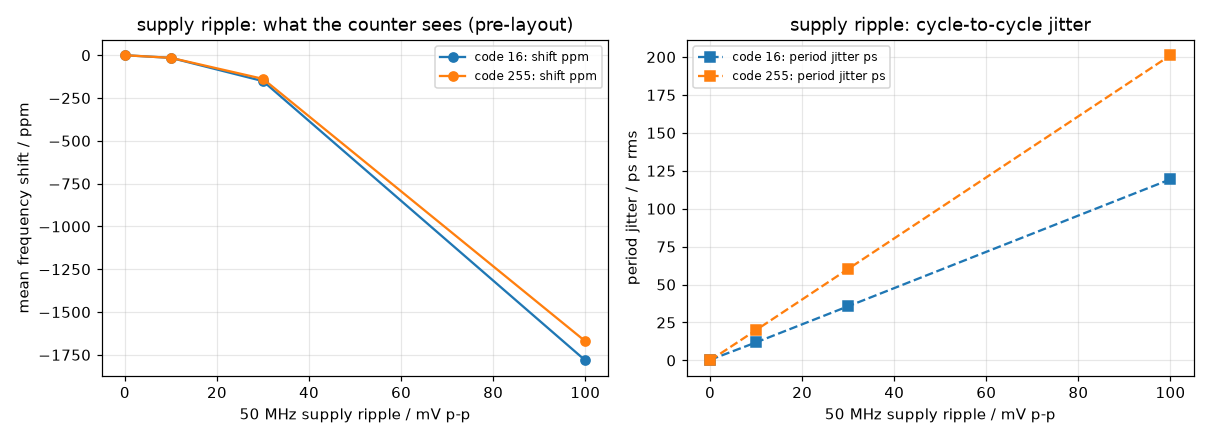
docs/verify_env.png
