mgpauly1458/ttihp26b-project/docs/verify_env_post.png

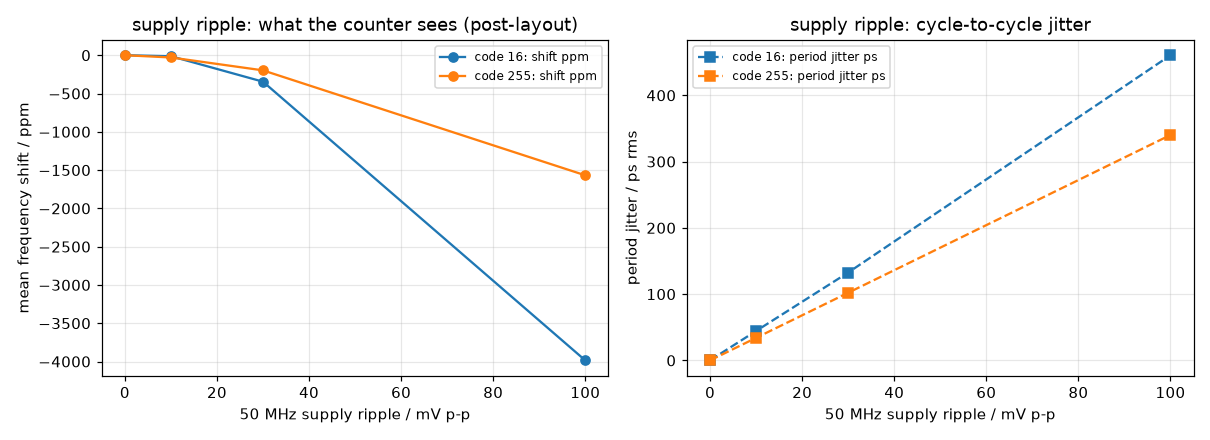
docs/verify_env_post.png
