mgpauly1458/ttihp26b-project/docs/verify_ring_mc.png

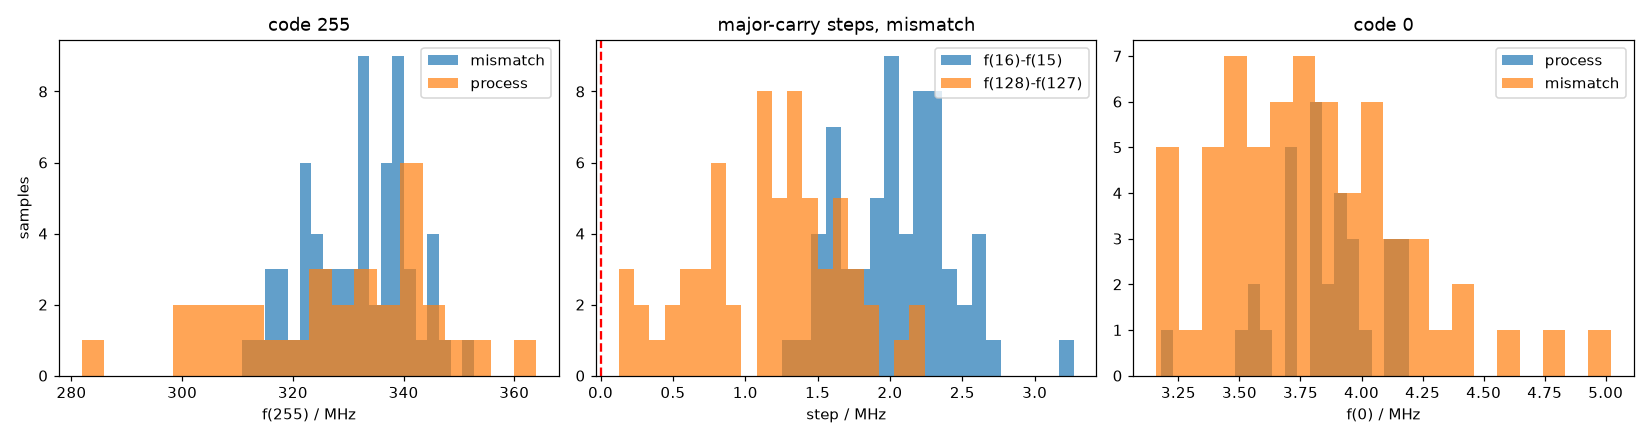
docs/verify_ring_mc.png
