mgpauly1458/ttihp26b-project/docs/verify_stage.png

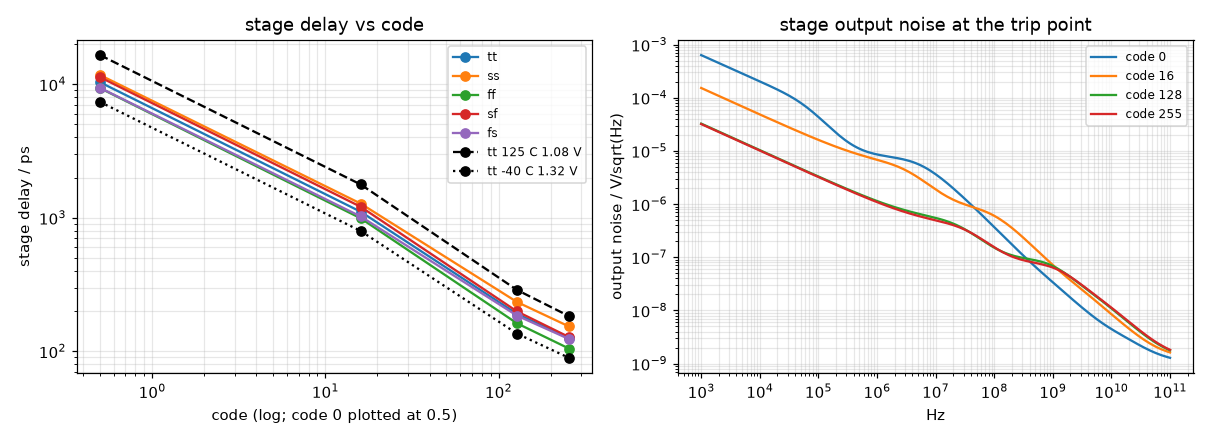
docs/verify_stage.png
