mgpauly1458/ttihp26b-project/analog/out/verify/tt_analog_ring.mm.spice

* tt_analog_ring: current-starved ring oscillator + 8-bit binary current DAC
* GENERATED by analog/layout/build_tt_analog_ring.py - do not edit.
* One line per transistor finger, as placed in the layout.
* ngspice form: subcircuit calls into the PDK models.
.subckt tt_analog_ring code[0] code[1] code[2] code[3] code[4] code[5] code[6] code[7] enable clk_out VPWR VGND
XD7r0h0_0 vbp code[7] VGND VGND sg13_lv_nmos w=0.15u l=8u ng=1 mm_ok=1
XD7r0h0_1 VGND code[7] vbp VGND sg13_lv_nmos w=0.15u l=8u ng=1 mm_ok=1
XD7r0h0_2 vbp code[7] VGND VGND sg13_lv_nmos w=0.15u l=8u ng=1 mm_ok=1
XD7r0h0_3 VGND code[7] vbp VGND sg13_lv_nmos w=0.15u l=8u ng=1 mm_ok=1
XD7r0h1_0 vbp code[7] VGND VGND sg13_lv_nmos w=0.15u l=8u ng=1 mm_ok=1
XD7r0h1_1 VGND code[7] vbp VGND sg13_lv_nmos w=0.15u l=8u ng=1 mm_ok=1
XD7r0h1_2 vbp code[7] VGND VGND sg13_lv_nmos w=0.15u l=8u ng=1 mm_ok=1
XD7r0h1_3 VGND code[7] vbp VGND sg13_lv_nmos w=0.15u l=8u ng=1 mm_ok=1
XD7r1h0_0 vbp code[7] VGND VGND sg13_lv_nmos w=0.15u l=8u ng=1 mm_ok=1
XD7r1h0_1 VGND code[7] vbp VGND sg13_lv_nmos w=0.15u l=8u ng=1 mm_ok=1
XD7r1h0_2 vbp code[7] VGND VGND sg13_lv_nmos w=0.15u l=8u ng=1 mm_ok=1
XD7r1h0_3 VGND code[7] vbp VGND sg13_lv_nmos w=0.15u l=8u ng=1 mm_ok=1
XD7r1h1_0 vbp code[7] VGND VGND sg13_lv_nmos w=0.15u l=8u ng=1 mm_ok=1
XD7r1h1_1 VGND code[7] vbp VGND sg13_lv_nmos w=0.15u l=8u ng=1 mm_ok=1
XD7r1h1_2 vbp code[7] VGND VGND sg13_lv_nmos w=0.15u l=8u ng=1 mm_ok=1
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
XMB1N_0 b1 s10 VGND VGND sg13_lv_nmos w=0.3u l=0.13u ng=1 mm_ok=1
XMB1P_0 b1 s10 VPWR VPWR sg13_lv_pmos w=0.5u l=0.13u ng=1 mm_ok=1
XMB2N_0 clk_out b1 VGND VGND sg13_lv_nmos w=1u l=0.13u ng=1 mm_ok=1
XMB2P_0 clk_out b1 VPWR VPWR sg13_lv_pmos w=2u l=0.13u ng=1 mm_ok=1
.ends
