mgpauly1458/ttihp26b-project/analog/out/verify/tt_analog_ring.pex.exposed.spice

* tt_analog_ring, post-layout: devices + kpex 2.5D parasitic capacitances
* GENERATED by analog/layout/build_sim_post.py from out/pex/tt_analog_ring_pex.spice - do not edit.
* Same ports as spice/tt_analog_ring.spice; internal nets vbp, vbn, s0..s10, b1 keep their names.
.subckt tt_analog_ring code[0] code[1] code[2] code[3] code[4] code[5] code[6] code[7] enable clk_out VPWR VGND vbp vbn
XM1 vbp code[0] VGND VGND sg13_lv_nmos w=0.15u l=8u ng=1
XM2 vbp code[1] VGND VGND sg13_lv_nmos w=0.15u l=8u ng=1
XM3 VGND code[1] vbp VGND sg13_lv_nmos w=0.15u l=8u ng=1
XM4 vbp VPWR VGND VGND sg13_lv_nmos w=0.15u l=8u ng=1
XM5 VGND VPWR vbp VGND sg13_lv_nmos w=0.15u l=8u ng=1
XM6 clk_out b1 VPWR VPWR sg13_lv_pmos w=2u l=0.13u ng=1
XM7 clk_out b1 VGND VGND sg13_lv_nmos w=1u l=0.13u ng=1
XM8 s3 s2 n_126 VPWR sg13_lv_pmos w=0.5u l=0.13u ng=1
XM9 s2 s1 n_125 VPWR sg13_lv_pmos w=0.5u l=0.13u ng=1
XM10 b1 s10 VPWR VPWR sg13_lv_pmos w=0.5u l=0.13u ng=1
XM11 s6 s5 n_128 VPWR sg13_lv_pmos w=0.5u l=0.13u ng=1
XM12 s10 s9 n_133 VPWR sg13_lv_pmos w=0.5u l=0.13u ng=1
XM13 s5 s4 n_129 VPWR sg13_lv_pmos w=0.5u l=0.13u ng=1
XM14 s9 s8 n_132 VPWR sg13_lv_pmos w=0.5u l=0.13u ng=1
XM15 s7 s6 n_130 VPWR sg13_lv_pmos w=0.5u l=0.13u ng=1
XM16 s4 s3 n_127 VPWR sg13_lv_pmos w=0.5u l=0.13u ng=1
XM17 s8 s7 n_131 VPWR sg13_lv_pmos w=0.5u l=0.13u ng=1
XM18 s1 s0 n_124 VPWR sg13_lv_pmos w=0.5u l=0.13u ng=1
XM19 s1 s0 n_71 VGND sg13_lv_nmos w=0.3u l=0.13u ng=1
XM20 b1 s10 VGND VGND sg13_lv_nmos w=0.3u l=0.13u ng=1
XM21 s7 s6 n_72 VGND sg13_lv_nmos w=0.3u l=0.13u ng=1
XM22 s8 s7 n_70 VGND sg13_lv_nmos w=0.3u l=0.13u ng=1
XM23 s3 s2 n_77 VGND sg13_lv_nmos w=0.3u l=0.13u ng=1
XM24 s2 s1 n_75 VGND sg13_lv_nmos w=0.3u l=0.13u ng=1
XM25 s6 s5 n_73 VGND sg13_lv_nmos w=0.3u l=0.13u ng=1
XM26 s10 s9 n_67 VGND sg13_lv_nmos w=0.3u l=0.13u ng=1
XM27 s4 s3 n_76 VGND sg13_lv_nmos w=0.3u l=0.13u ng=1
XM28 s9 s8 n_69 VGND sg13_lv_nmos w=0.3u l=0.13u ng=1
XM29 s5 s4 n_74 VGND sg13_lv_nmos w=0.3u l=0.13u ng=1
XM30 s0 enable n_122 VPWR sg13_lv_pmos w=0.5u l=0.13u ng=1
XM31 n_122 s10 s0 VPWR sg13_lv_pmos w=0.5u l=0.13u ng=1
XM32 n_I1005 enable n_68 VGND sg13_lv_nmos w=0.6u l=0.13u ng=1
XM33 s0 s10 n_I1005 VGND sg13_lv_nmos w=0.6u l=0.13u ng=1
XM34 vbn vbn VGND VGND sg13_lv_nmos w=0.5u l=0.5u ng=1
XM35 n_72 vbn VGND VGND sg13_lv_nmos w=0.5u l=0.5u ng=1
XM36 n_77 vbn VGND VGND sg13_lv_nmos w=0.5u l=0.5u ng=1
XM37 n_68 vbn VGND VGND sg13_lv_nmos w=0.5u l=0.5u ng=1
XM38 n_75 vbn VGND VGND sg13_lv_nmos w=0.5u l=0.5u ng=1
XM39 n_73 vbn VGND VGND sg13_lv_nmos w=0.5u l=0.5u ng=1
XM40 n_69 vbn VGND VGND sg13_lv_nmos w=0.5u l=0.5u ng=1
XM41 n_76 vbn VGND VGND sg13_lv_nmos w=0.5u l=0.5u ng=1
XM42 n_67 vbn VGND VGND sg13_lv_nmos w=0.5u l=0.5u ng=1
XM43 n_71 vbn VGND VGND sg13_lv_nmos w=0.5u l=0.5u ng=1
XM44 n_74 vbn VGND VGND sg13_lv_nmos w=0.5u l=0.5u ng=1
XM45 n_70 vbn VGND VGND sg13_lv_nmos w=0.5u l=0.5u ng=1
XM46 vbn vbp VPWR VPWR sg13_lv_pmos w=1u l=0.5u ng=1
XM47 n_130 vbp VPWR VPWR sg13_lv_pmos w=1u l=0.5u ng=1
XM48 n_122 vbp VPWR VPWR sg13_lv_pmos w=1u l=0.5u ng=1
XM49 n_128 vbp VPWR VPWR sg13_lv_pmos w=1u l=0.5u ng=1
XM50 n_125 vbp VPWR VPWR sg13_lv_pmos w=1u l=0.5u ng=1
XM51 n_124 vbp VPWR VPWR sg13_lv_pmos w=1u l=0.5u ng=1
XM52 n_127 vbp VPWR VPWR sg13_lv_pmos w=1u l=0.5u ng=1
XM53 n_126 vbp VPWR VPWR sg13_lv_pmos w=1u l=0.5u ng=1
XM54 n_132 vbp VPWR VPWR sg13_lv_pmos w=1u l=0.5u ng=1
XM55 n_129 vbp VPWR VPWR sg13_lv_pmos w=1u l=0.5u ng=1
XM56 n_133 vbp VPWR VPWR sg13_lv_pmos w=1u l=0.5u ng=1
XM57 n_131 vbp VPWR VPWR sg13_lv_pmos w=1u l=0.5u ng=1
XM58 vbp vbp VPWR VPWR sg13_lv_pmos w=2u l=0.5u ng=1
XM59 VPWR vbp vbp VPWR sg13_lv_pmos w=2u l=0.5u ng=1
XM60 vbp vbp VPWR VPWR sg13_lv_pmos w=2u l=0.5u ng=1
XM61 VPWR vbp vbp VPWR sg13_lv_pmos w=2u l=0.5u ng=1
XM62 vbp vbp VPWR VPWR sg13_lv_pmos w=2u l=0.5u ng=1
XM63 VPWR vbp vbp VPWR sg13_lv_pmos w=2u l=0.5u ng=1
XM64 vbp vbp VPWR VPWR sg13_lv_pmos w=2u l=0.5u ng=1
XM65 VPWR vbp vbp VPWR sg13_lv_pmos w=2u l=0.5u ng=1
XM66 vbp vbp VPWR VPWR sg13_lv_pmos w=2u l=0.5u ng=1
XM67 VPWR vbp vbp VPWR sg13_lv_pmos w=2u l=0.5u ng=1
XM68 vbp vbp VPWR VPWR sg13_lv_pmos w=2u l=0.5u ng=1
XM69 VPWR vbp vbp VPWR sg13_lv_pmos w=2u l=0.5u ng=1
XM70 vbp vbp VPWR VPWR sg13_lv_pmos w=2u l=0.5u ng=1
XM71 VPWR vbp vbp VPWR sg13_lv_pmos w=2u l=0.5u ng=1
XM72 vbp vbp VPWR VPWR sg13_lv_pmos w=2u l=0.5u ng=1
XM73 VPWR vbp vbp VPWR sg13_lv_pmos w=2u l=0.5u ng=1
XM74 vbp vbp VPWR VPWR sg13_lv_pmos w=2u l=0.5u ng=1
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
Cext_325 VGND s2 736.105a
Cext_326 VGND s3 736.105a
Cext_327 VGND s4 736.105a
Cext_328 VGND s5 736.105a
Cext_329 VGND s6 736.071a
Cext_330 VGND s7 735.881a
Cext_331 VGND s8 735.754a
Cext_332 VGND s9 732.77a
Cext_333 VGND vbn 5.4132f
Cext_334 VGND vbp 33.0044f
.ends tt_analog_ring
