mgpauly1458/ttihp26b-project/(commit log)

2026-09-05 Add Basys3 prototype harness and local workflow docs
    Wraps the unmodified TT pin interface onto Basys3 peripherals so the same
    RTL can be exercised on hardware: switches drive ui_in/uio_in, LEDs and the
    7-segment display show uo_out/uio_out, btnC resets, and the DUT clock is a
    divided 100 MHz with a btnD/btnU single-step mode.
    The clock divide factor lives in build.tcl so the create_generated_clock
    constraint stays in sync with the synthesised parameter. Pin constraints are
    extracted from Digilent's Basys-3-Master.xdc rather than transcribed.
    Claude-Session: https://claude.ai/code/session_019Su6ch64Vwo5tpzFpjNs28
2026-09-05 Use 1x2 for the two-tile budget and fill in required project metadata
    CI rejected 2x1: tile_sizes.yaml lists geometry for the Nx1 sizes, but
    tt-support-tools ships no tt_block_Nx1_pgvdd.def template for them, so they
    cannot be hardened. 1x2 is the buildable two-tile option.
    Also renames the top module off tt_um_example, which would collide with other
    submissions, and fills in the title/author/description/pinout and info.md
    sections that the docs and gds workflows require.
    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
    [project.v, tb.v]
2026-09-05 Convert to an analog custom-GDS project: hand-drawn CMOS inverter
    Turns the tile into a Tiny Tapeout analog submission built around a
    hand-laid-out inverter, as an end-to-end check of the analog flow before
    anything larger is attempted.
    An analog project is a custom-GDS submission: gds/ and lef/ hold the tile,
    src/project.v is a blackbox stub, and nothing is synthesised. Swaps in the
    analog template's gds workflow (tt-gds-action/custom_gds) and drops the
    cocotb bench and Basys3 harness, which are digital-only and stay on main.
    The tile is 202.08x313.74um per tt_analog_1x2.def. Signals reach TopMetal1
    pads on the bottom edge through via_stack PCells; VDPWR/VGND are vertical
    Metal4 stripes s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
    [inverter.sch, inverter_tb.sch, tt_um_mgpauly1458_inverter.sch]
2026-09-05 Generate LEF pins and their geometry from the analog DEF template
    TT precheck requires the LEF to declare every pin in the tile interface, not
    just the ones the design connects to:
    ERROR: Pin clk not found in .../tt_um_mgpauly1458_inverter.lef
    Rather than hand-write 51 entries, parse them out of tt_analog_1x2.def. That
    keeps the names, layers and positions agreeing with what the shuttle expects,
    and draws the matching metal in the GDS so the LEF isn't describing geometry
    that isn't there. Unused inputs end up as unconnected stubs, which is correct.
    Still 0 DRC violations and LVS matching after the change.
    Claude-Session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
2026-09-05 Move power pins to TopMetal1 at 2.6um, per precheck
    Precheck rejected the Metal4 stripes:
    ERROR: Port VDPWR has wrong layer ...: Metal4 != TopMetal1
    ERROR: Port VGND has too small width ...: 2.0 < 2.1 um
    The published analog spec quotes Metal4 and 1.2um, but that is the sky130
    guidance; precheck is the authority for IHP.
    Putting the stripes on TopMetal1 puts them on the same layer as the ua
    routing, so they move well clear of the signal corridor at x=165560..192040
    and are fed from the core by Metal4 spurs, which pass under the signal routes
    harmlessly. A Metal4 -> TopMetal1 via stack joins each spur to its stripe.
    Still 0 DRC violations and LVS matching.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
2026-09-05 Satisfy TT precheck: pin purposes, boundary layer, layer allowlist
    Four failures from the precheck report, all in the GDS rather than the design:
    - Pin check wants every LEF port rect to also exist as a polygon on the
    matching <layer>.pin (50/2, 126/2) containing that rect. Now emitted from
    the same PINS table as the LEF.
    - prBoundary must be 189/4 (prBoundary.boundary); 189/0 (.drawing) is not on
    the allowed layer list.
    - The device PCells draw HeatTrans (51/0), also not allowed. Cleared across
    all cells; it takes no part in DRC or LVS, both of which still pass.
    - KLayout emits a hidden 6634666346$ cell holding PCell parameters.
    gdstk, which precheck uses, counts it as a second t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
2026-09-05 Record the precheck lessons in the analog README
    Every precheck failure was about how the GDS is written rather than the
    circuit, and all of them will recur on the next analog block. Writing them
    down is most of the value of this exercise.
    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
2026-09-06 Document the flow and make both pipelines reproducible
    Adds CLAUDE.md covering the shuttle constraints, the two-branch layout, and
    every trap hit getting from a working circuit to a passing precheck. The
    circuit was DRC and LVS clean long before precheck was, and all the remaining
    failures were about how the GDS is written, so those are written down rather
    than left to be rediscovered.
    Reworks analog/Makefile around the distinction that actually matters:
    make design is the circuit right, and does the layout match it?
    netlist -> sim -> gds -> drc -> lvs
    make tt will Tiny Tapeout accept it?
    drc -> lvs -> precheck
    plus make help/ci/shell and the in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
2026-09-06 Make each flow step an independent target
    The steps existed but were all .PHONY, so 'make lvs' silently re-ran the
    layout build and both netlists every time. Each step is now driven by the
    artefact it produces, with real prerequisites, so it does its own work and
    only when its inputs changed:
    netlist-sim -> out/<TB>.spice netlist-lvs -> out/<TOP>.spice
    sim -> out/*.data/*.raw plot -> docs/inverter_sim.png
    gds -> gds/*.gds + lef/*.lef png -> docs/inverter_layout.png
    drc / lvs / precheck -> stamps under out/
    netlist splits into netlist-sim and netlist-lvs, since the two are not
    interchangeable and mixing them up is the easies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
2026-09-06 Parameterise every flow step by CELL
    The steps were hardwired to the one inverter tile. Each now takes a CELL and
    derives its paths from it, so the same commands work for any block added later:
    make sim CELL=inverter simulate xschem/inverter_tb.sch
    make gds CELL=someblock build layout/build_someblock.py
    make drc CELL=someblock DRC that block, in its own run directory
    make lvs CELL=someblock against its own schematic
    CELL defaults to the top module read out of ../info.yaml, so a bare 'make drc'
    still means the submission tile. GDS, NETLIST, BUILD, TB and PLOT can each be
    overridden for a block that does not follow the conventions.
    Conventions, documented in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
2026-09-06 Merge a LibreLane digital macro into the analog tile
    Snapshot of the analog-top arrangement: the hand-built tile imports
    digital/out/ms_hello.gds and hand-routes it. Superseded by the digital-top
    flow on the digital-top branch, kept here as a working fallback.
    Claude-Session: https://claude.ai/code/session_017xJfgGgiQrsnC52iU7fZ51
    [pin_order.cfg]
2026-09-07 Invert the hierarchy: digital tile importing the analog block
    The tile was an analog custom-GDS top level with a LibreLane macro merged
    into it. It is now the other way round: the Verilog top level is the whole
    tile, LibreLane hardens it, and the hand-drawn CMOS inverter goes in as a
    hard macro that the flow places, routes to and powers.
    That makes this a DIGITAL submission - analog_pins is 0, no ua[] pad is
    touched - so Tiny Tapeout's ordinary tt-gds-action builds it and the repo
    holds no GDS of the tile. It is possible because tt-support-tools merges its
    generated config over src/config.json for only the seven keys it owns, so
    MACROS and the PDN hookup survive into the LibreLane run. A pr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
    [pin_order.cfg, tt_analog_inverter.sch, tt_um_mgpauly1458_inverter.sch]
2026-09-07 Thread GDS/CELL through to the glb builder so make view works on the hardened tile
    build_glb.py hardcoded the old analog-inverter branch's GDS path, so `make view`
    from the repo root failed after the digital-top restructuring.
    Claude-Session: https://claude.ai/code/session_017gB2Yc2F7knf1wkaXkHqqQ
2026-09-07 Track analog PEX/sim tooling and doc images; set up Git LFS for binary assets
    Adds PEX schematic/sim-post build scripts, updated xschem schematics, and a
    quick reference doc. Ignores regenerable analog run artifacts (drc_run_*,
    lvs_run_*, macro/backups, simulations, extracted netlists). GDS files and
    docs/*.png now go through Git LFS.
    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
    [inverter.sch, inverter_tb.sch, tt_analog_inverter.sch, tt_analog_inverter_pex_viz.sch]
2026-09-07 Start the ring oscillator frequency meter on a fresh branch
    Replace the mixed-signal hello world (kept on main and analog-inverter as
    the reference for importing a custom GDS macro into a digital tile) with
    the instrument from the project brief: a reciprocal frequency counter that
    measures any of eight on-chip ring oscillators and reports the count over
    the Tiny Tapeout pins.
    RTL (src/): regfile with the pin protocol, measure_core (window FSM with a
    CLEAR state found necessary by the timeout-recovery test), cdc_sync,
    ring_divider (7 flops, 8 taps), ring_mux (one-hot enables), and the
    structural ring netlists (four identical 21-stage, high-drive, 11-stage,
    tap-select, analog stub) instantiat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
    [inverter.sch, inverter_tb.sch, tt_analog_inverter.sch, tt_analog_inverter_pex_viz.sch]
2026-09-07 Add the analog block: current-starved ring oscillator with an 8-bit current DAC
    A hand-generated hard macro (analog/) replacing the hello-world inverter:
    255 unit NMOS fingers (0.15/8um) switched straight by the code bits into a
    diode-connected PMOS, mirrored into an 11-stage current-starved ring with a
    NAND enable and an output buffer. The KLayout generator emits the GDS, the
    LEF and both netlists from one connectivity description. Block-level DRC
    (maximal rule set, no density) is clean and LVS matches.
    Claude-Session: https://claude.ai/code/session_015Tacz89PxZ2SXmV2nwrvNE
2026-09-07 Analog block: 2um diode fingers (48:1), two always-on units, tie columns; DRC clean, LVS matches
    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
2026-09-07 Analog block: xschem schematic of the ring, LVS-checked against the layout
    Five sheets (top, DAC, NAND, stage, inverter) written by xschem/make_sch.py
    from the layout generator's size constants; make lvs-sch netlists them flat
    and KLayout LVS matches the GDS. Renders in docs/sch_*.png.
    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
    [csro_dac.sch, csro_inv.sch, csro_nand.sch, csro_stage.sch, tt_analog_ring.sch]
2026-09-07 Integrate the analog ring macro into the tile; constrain the ring clocks
    ring slot 7 is now the hard macro: src/rings/tt_analog_ring.v is the
    blackbox (behavioural model under SIM), MACROS/PDN_MACRO_CONNECTIONS/
    PDN_HORIZONTAL_LAYER in src/config.json place and power it, placed clear
    of the PDN strap edges so every crossing strap gets its vias.
    src/constraints.sdc sources LibreLane's base.sdc and declares the eight
    ring outputs, the selected ring and the divided ring as asynchronous
    clocks. The selected and divided clocks hang on named (* keep *) buffers
    added in ring_mux and ring_divider; the divided ring is constrained to
    250 MHz, which is the instrument's one usage rule (fast rings throu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
2026-09-07 Store the macro GDS and figures as plain git objects, not Git LFS
    Tiny Tapeout's GDS action checks the repository out without LFS, so the
    macro arrived as a pointer file and Magic could not stream it in
    (CI run 34158145310, 'Error while reading cell (UNNAMED)'). The files
    are small; plain blobs are what the shuttle build needs.
    Also: analog/verify/ bias, stage, NAND, buffer and whole-block tests,
    Makefile targets, report assembler; docs/analog_layout_notes.md.
    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
2026-09-07 SDC: ring clock periods from the fast-corner simulation; tap rule in the docs
    The analog macro reaches 544 MHz at code 255 at ff/-40 C/1.32 V, so its
    clock and the selected-ring clock are constrained at 1.6 ns / 0.8 ns.
    Still 0 setup/hold violations; the divided ring stays at 4.0 ns and the
    docs say which tap keeps it under 250 MHz for every ring at every corner.
    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
2026-09-07 Analog verification: results appendix, figures, and the write-up's reading of them
    Whole block over 45 PVT points, 64 mismatch + 32 process Monte Carlo
    samples, bias-noise injection; every block on its schematic sheet. All
    monotonic, stopped ring holds everywhere, noise below the counter's
    resolution; the thin spots (127->128 carry margin, bias flicker on vbn)
    are named with their fixes.
    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
2026-09-07 Post-layout flow and environment test: kpex extraction, per-block attribution, pre/post comparison, tile-noise cases
    make pex / sim-post / verify-ring-post / lib-post / verify-env(-post).
    ngspice pinned to one thread per deck (the container's 8-thread default
    thrashed the machine). Also picks up the 3D-view targets someone else
    added to analog/Makefile.
    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
2026-09-07 Liberty characterised on the post-layout netlist; make lib runs kpex first
    Code pins 18 fF..1.52 pF (the buses add 16..90 %), enable 13 fF, clk_out
    edges include its wire. Tile re-hardened: 0 violations, DRC/LVS/antenna
    clean, precheck passes.
    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
2026-09-08 Post-layout whole-block results: 45/45 monotonic, 1 of 64 mismatch samples reverses the 127-128 step; write-ups say so
    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
2026-09-08 analog: commit simulation, PEX, DRC/LVS and characterisation data (LFS)
    analog/out is no longer ignored. The corner, Monte Carlo, noise,
    environment and PEX runs (about an hour each on 14 cores) are stored so
    VERIFY_REUSE=1 re-analyses them instead of re-simulating. Data files
    (*.txt waveforms and the like) go through Git LFS under analog/out only;
    nothing the Tiny Tapeout build reads uses LFS. The yosys wasm cache and
    tile_3d.glb stay ignored.
    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
    [bias_corners.csv, bias_mm.csv, bias_noise.csv, buffer_corners.csv, dac_corners.csv, dac_mm.csv, dac_stat.csv, env.csv]
2026-09-08 docs, comments: rewrite everything as compact quick references
    Every Markdown document and every file header and inline comment in src/,
    sim/, test/, scripts/ and analog/ is replaced by the shortest text that
    still gives what the thing is, its interface, and the non-obvious why.
    No code changed: Verilog/SDC/Makefile non-comment lines and the Python
    AST minus docstrings are byte-identical to the previous commit, so the
    stored simulation decks still match and VERIFY_REUSE=1 re-analyses them.
    run.sh passes VERIFY_REUSE into the container, so
    VERIFY_REUSE=1 make -C analog verify ... regenerates the tables and
    figures from the committed runs in under a minute; this run completed the
    pre/post fre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
    [cdc_sync.v]
2026-09-21 make view, regenerated schematic, stretch-goal notes, personal area notes
    - Makefile: `make view` writes the hardened tile as glTF; tool targets are .PHONY
    - build_glb.py: default cell is tt_analog_ring (was the old inverter top)
    - analog/xschem/tt_analog_ring.sch: wires and annotations as last generated
    - docs/stretch, analog_stretch: Banba bandgap + sigma-delta readout, idea and
    unsized skeleton netlist only; not integrated, not in info.yaml
    - design_notes_personal.md: die area / utilization numbers and where they come from
    - tt_analog_ring_extracted.cir: KLayout LVS extraction of the macro, for reference
    None of this is read by the Tiny Tapeout build. The submitted revision is the
    tag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
    [tt_analog_ring.sch]
2026-09-21 stats_observer: count/min/max/sum of RESULT and a dice byte on the ui_in[7] page
    A passive clk-domain block that samples measure_core's result each time done
    rises without timeout_error. With ui_in[7] = 1, uo_out shows the byte indexed
    by uio_in[4:0]: COUNT, MIN, MAX (16 bit), SUM (32 bit), an LFSR dice byte,
    0x5A and "RING METER 26B". Cleared by any accepted configuration write.
    With ui_in[7] = 0 the pins behave exactly as in the submitted 6dbf460.
    - 16 bits suffice: the 16-bit timeout counter covers the whole measurement,
    so a good RESULT is below 65536. A first 32/48-bit version took utilization
    to 81 %; this one is 67 % (was 48 %).
    - regfile.v: cfg_write out, stats_byte in, one `if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
